Escape9002/ArcherTracking/3D-Boxen/README.md

This directory hold the cases in which the die is placed and attached to the body.
