Escape9002/ArcherTracking/Arduino_Code/README.md

Here is every firmware and a few tests for the BLE-Communication and the MPU9250.

## used:
- Arduino Nano 33 BLE
    - I²C
    - 3,3V
- MPU9250
    - I²C
    - 3,3V
    - DigitalMotionProcessor
    - Accleration, Gyroscope, Magnetometer (all in x,y,z)
