Escape9002/ArcherTracking/Documentation/2020/Hardware/Hardware.txt

- Arduino Nano 33 BLE
- MPU9250
- 9V-Battery
