Escape9002/ArcherTracking/Documentation/2021/Papers/sources.tex

\begin{itemize}
    \item Zuletzt besucht am 12.1.2022 | \textit{HowToMechatronics}\\
        \url{https://howtomechatronics.com/how-it-works/electrical-engineering/mems-accelerometer-gyrocope-magnetometer-arduino/}
    \item Zuletzt besucht am 12.1.2022 | \textit{NovelBits} \\
        \url{https://www.novelbits.io/bluetooth-5-speed-maximum-throughput/}
    \item Zuletzt besucht am 12.1.2022 | \textit{Journal of Mechanical Engineering and Sciences (JMES)} \\
        \url{http://jmes.ump.edu.my/images/Volume_6/4_Ahmad%20et%20al.pdf}
        %carefull this is an official PDF, cite it correctly
    \item Zuletzt besucht am 12.1.2022 | \textit{BatteryEquivalents}\\
        \url{https://www.batteryequivalents.com/lithium-cr2025-dl2025-e-cr2025-sb-t14-5003lc-br2025-lir2025-battery-equivalents.html}
    \item Zuletzt besucht am 12.1.2022 | \textit{akkuline.de}\\
        \url{https://www.akkuline.de/test/varta-high-energy-9v-batterie-test-messung}
    \item Zuletzt besucht am 12.1.2022 | \textit{Youtube | Google TechTalks} \\
        \url{https://www.youtube.com/watch?v=C7JQ7Rpwn2k}
    \item Zuletzt besucht am 2.3.2022 | \textit{Didaktik Mathematik HU Berlin | Quaternionen: von Hamilton, Basketbällen und anderen Katastrophen}
        \url{http://didaktik.mathematik.hu-berlin.de/files/2011_quaternionen.pdf}
\end{itemize}
