Escape9002/ArcherTracking/Documentation/2021/Papers/ArdFirmware.tex

Das selbst geschriebene Programm auf dem Arduino Nano 33 BLE stellt zu Beginn eine 
I$^2$C Verbindung mit dem MPU9250 her und startet das BLE-Modul.\\
Sobald ein Ger"at sich mit dem Arduino verbindet, beginnt dieser
mit der Datenübertragung.\\
Hierbei wurden die Filter vom Digital-Motion-Processor des MPU9250 
schon mit einem Low-Pass-Filter verarbeitet.
