Escape9002/ArcherTracking/Documentation/2021/Papers/Arduino.tex

Der Arduino Nano 33 BLE ist ein Prozessor aus dem Hause Arduino
der Nano Reihe. Was diesen von der normalen Nano-Reihe unterscheidet ist der BLE-Chip
NINA-b3(nRF52840) auf seinem Rücken. Dieser Chip ermöglicht es dem Arduino über 
Bluetooth 5.0, auch Bluetooth-Low-Energy genannt, mit allen anderen Bluetooth-Geräten ab 
der Bluetooth Version 4.0 kabellos zu kommunizieren.\\
\\
\begin{tabularx}{0.8\textwidth}{l|X}
Eigenschaft & Daten \\
\hline
Memory & 1MB Flash | 256 KB SRAM \\ 

Interfaces & $I^2C$, SPI, \dots \\

Volt & Input: 4,5 - 21 V | Output: 3,3 V\\
\end{tabularx}
\\
\\
Der Arduino ist aufgrund seines BLE-Chips, der I²C-Verbindungsmöglichkeit und der 
Output-Volt Zahl von 3,3 Volt der richtige Prozessor für dieses Projekt. Auch die 
kleinen Maße und das geringe Gewicht bringen ihm nur Pluspunkte ein.

% bringen statt spielen im letzen Satz? Sinnvoll ja/nein?
