Escape9002/ArcherTracking/Documentation/2021/Papers/winkMess.tex

Die Winkel Roll und Pitch können sehr genau bestimmt werden, hier die Tests:
