Escape9002/ArcherTracking/Documentation/2020/Papers/Plaktidee 1.pdf

Arduino Nano 33 BLE
- BLE-Chip
eingebaut
- klein + leicht

Bluetooth 4.0
Auch BLE genannt:
- geringer
Stromverbrauch
- Hohe Datenrate
- Starnetwork möglich

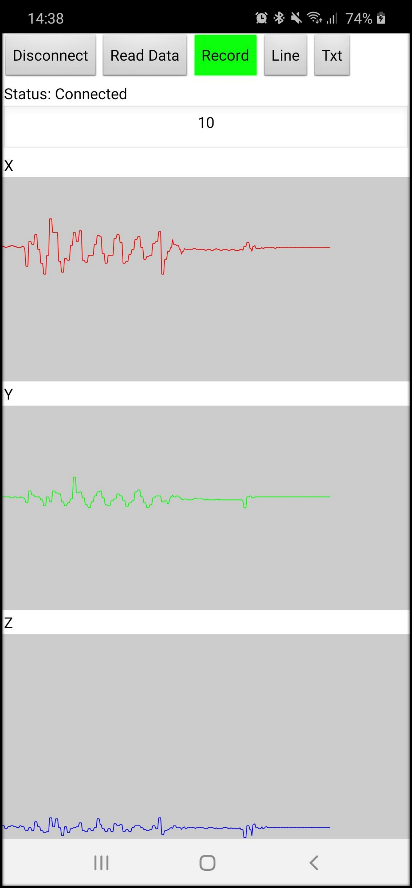
[picture p11: figure]

Bluetooth Low
Energy

MPU9250
→Multi-Chip (Achsen: 3)
- Beschleunigungssensor
- Gyroskop
- Magnetometer

I²C-BUS

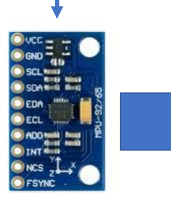
[picture p12: figure]

Mögliche 400kHz Senderate
(für alle Sensoren)

# Schützenvermessung als DIY-Version

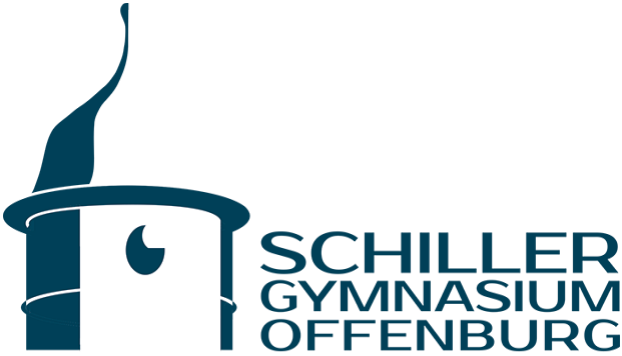
[picture p13: figure]

ein Projekt von Antonio Rehwinkel

Idee: Tracking eines Bogenschützen
→ altes System: teuer, kompliziert, platzintensiv →neues System: günstig, intuitiv, klein

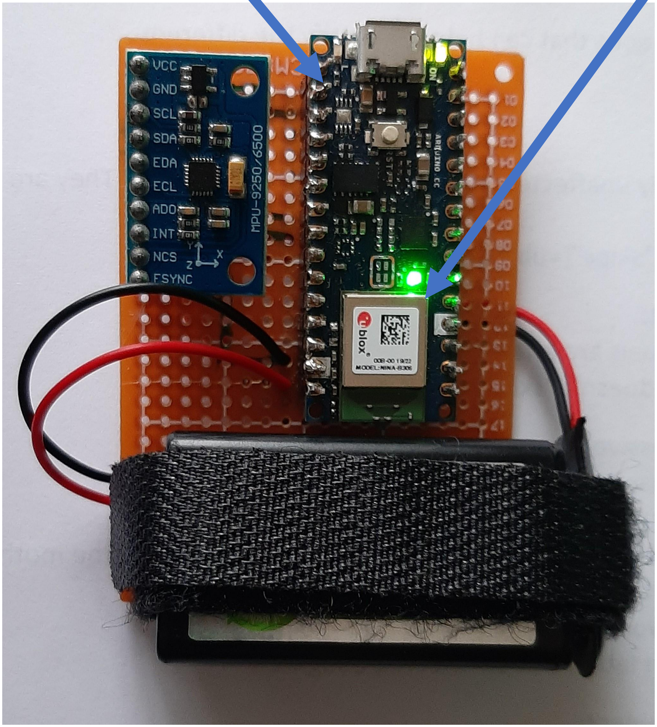
[picture p14: figure]

Getestete Senderate:
- Arduino: 22 Hz
- Smartphone: 52 Hz
