Escape9002/ArcherTracking/Documentation/2021/Papers/Danksagung.tex

Danke an \\
\begin{itemize}
    \item Herr Czernohous (Korrekturlesen der Arbeit und technische Hilfe, Kauf der Materialien) [Schiller Gymnasium Offenburg]
    \item Herr Dierle (Hilfe bei physikalischen Zusammenhängen und Formeln, Korrekturlesen der Arbeit) [Schiller Gymnasium Offenburg]
    \item R. Echle und R. Hilterhaus (f"ur Arbeitsideen und Hilfestellung) [Hochschule Offenburg]
\end{itemize}
