Escape9002/ArcherTracking/Documentation/2020/Hardware/dieBackside.jpg

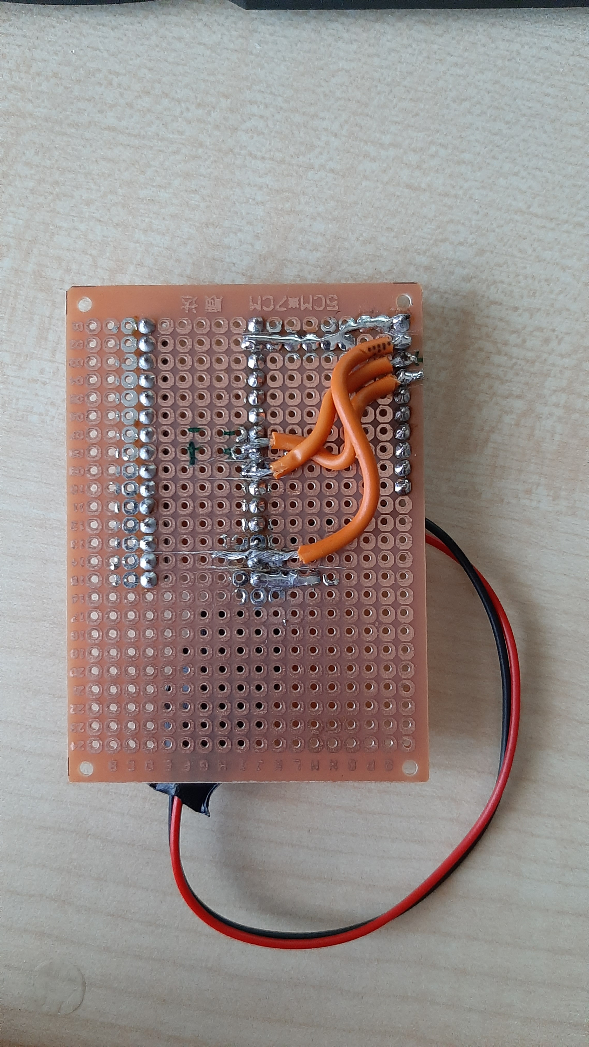
Documentation/2020/Hardware/dieBackside.jpg
