Escape9002/ArcherTracking/Documentation/2020/Hardware/dieFrontside.jpg

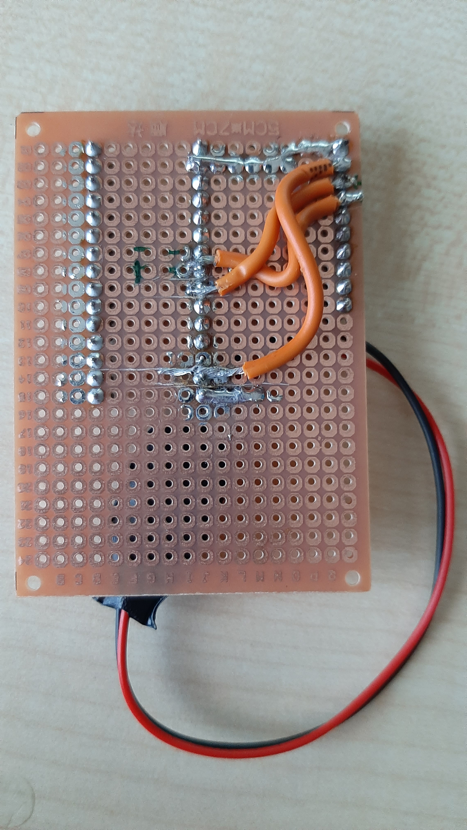
Documentation/2020/Hardware/dieFrontside.jpg
