Escape9002/ArcherTracking/Documentation/2020/Software/accelerationDetection.jpg

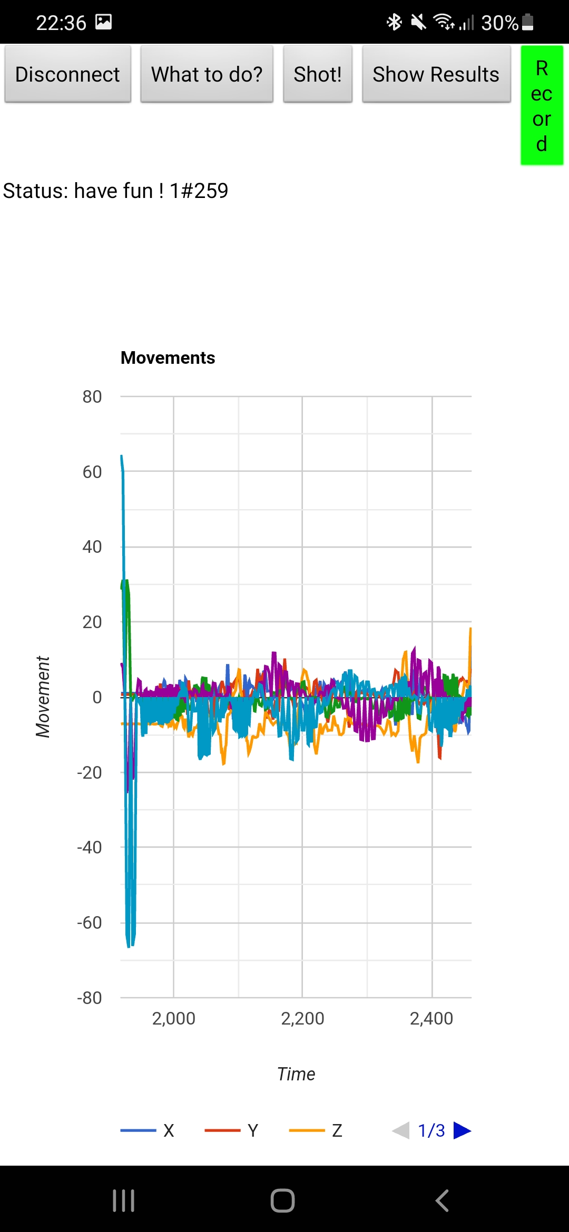
Documentation/2020/Software/accelerationDetection.jpg
