Escape9002/ArcherTracking/Documentation/2020/Software/textView.jpg

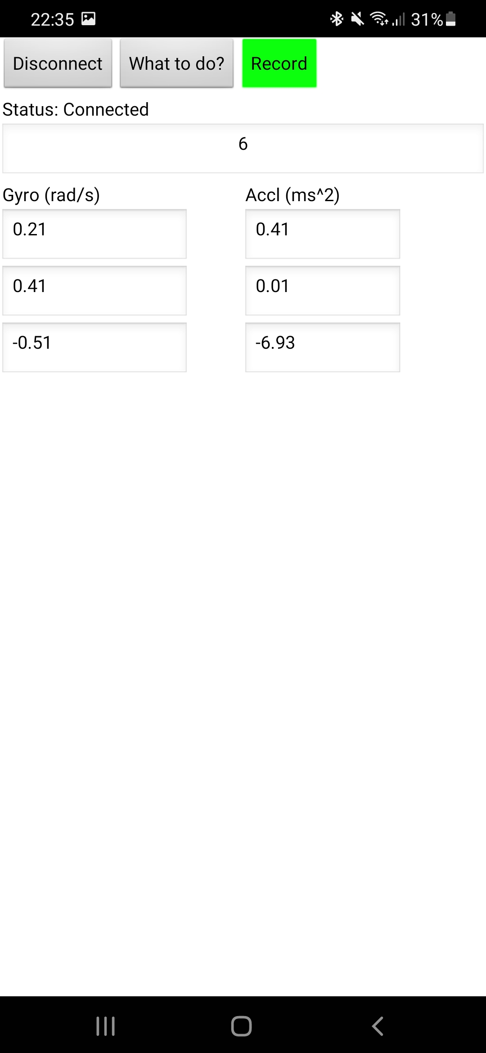
Documentation/2020/Software/textView.jpg
