Escape9002/ArcherTracking/Documentation/2021/Papers/Bilder/_integralDistance10.png

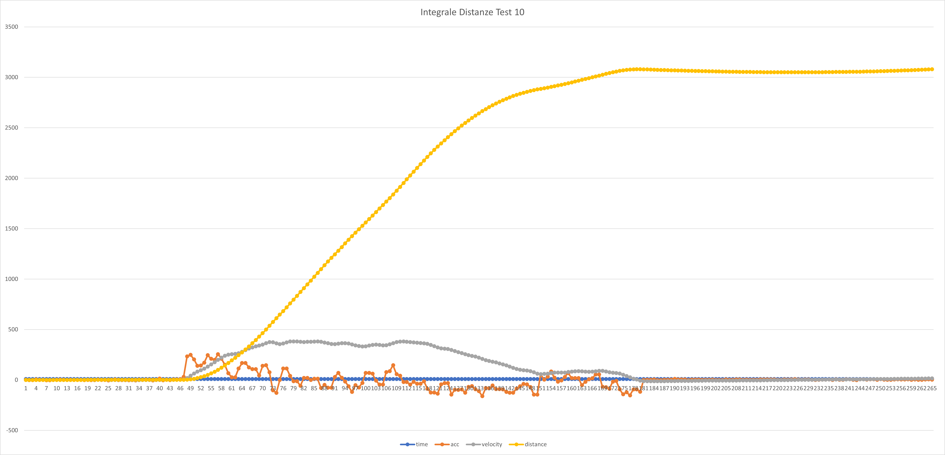
Documentation/2021/Papers/Bilder/_integralDistance10.png
