Escape9002/ArcherTracking/Documentation/2021/Papers/Bilder/constDistance1.png

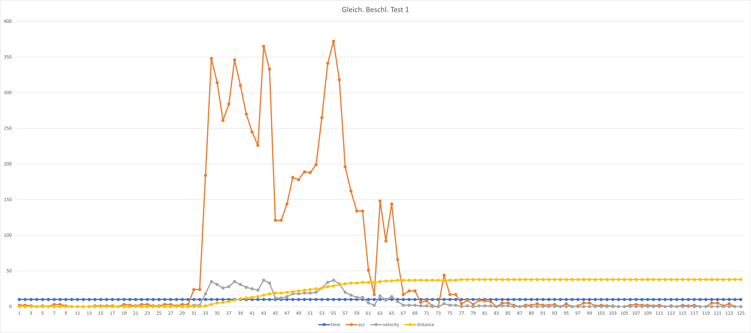
Documentation/2021/Papers/Bilder/constDistance1.png
