Escape9002/ArcherTracking/Documentation/2021/Papers/Bilder/constDistance2.png

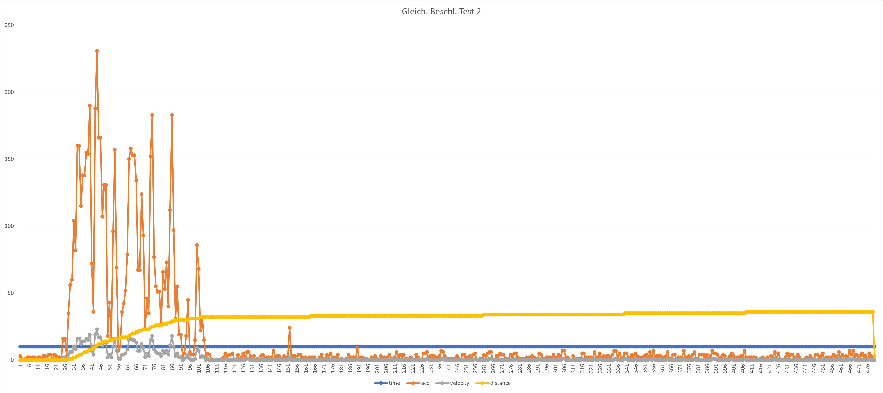
Documentation/2021/Papers/Bilder/constDistance2.png
