Escape9002/ArcherTracking/Documentation/2021/Papers/Bilder/graphAnimation.jpg

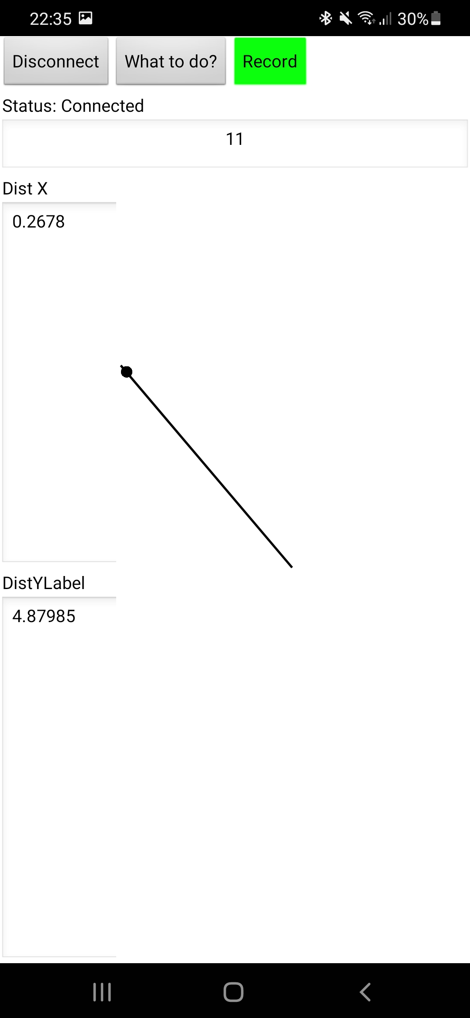
Documentation/2021/Papers/Bilder/graphAnimation.jpg
