Escape9002/ArcherTracking/Documentation/2021/Papers/Bilder/GraphAuswahl.jpg

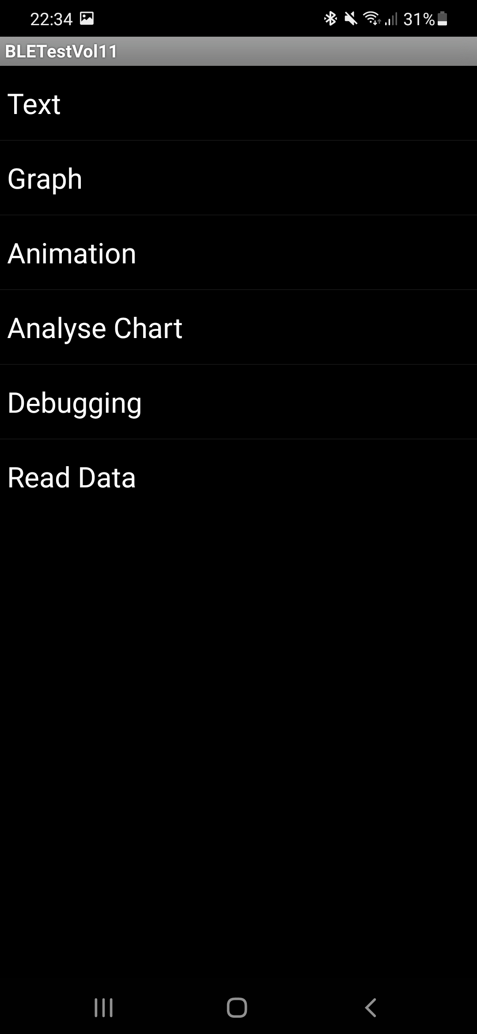
Documentation/2021/Papers/Bilder/GraphAuswahl.jpg
