Escape9002/ArcherTracking/Documentation/2021/Papers/Bilder/integralDistance3.png

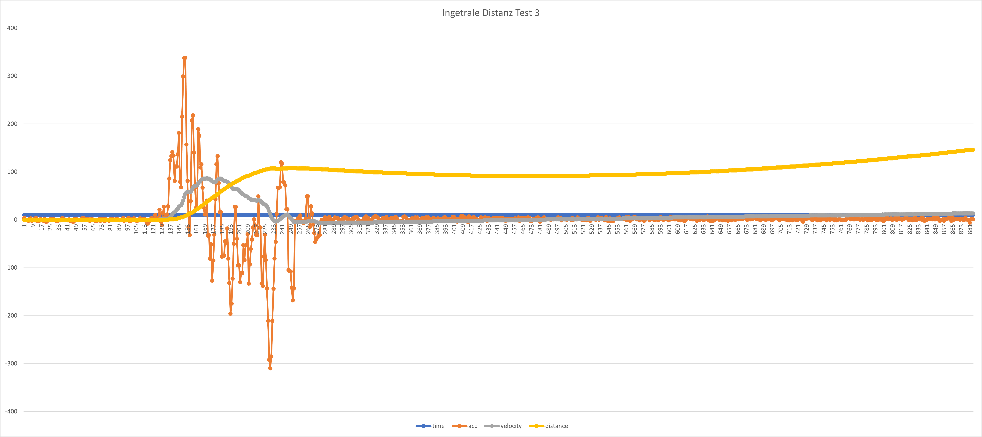
Documentation/2021/Papers/Bilder/integralDistance3.png
