Escape9002/ArcherTracking/Documentation/2021/Papers/Bilder/integralDistance4.png

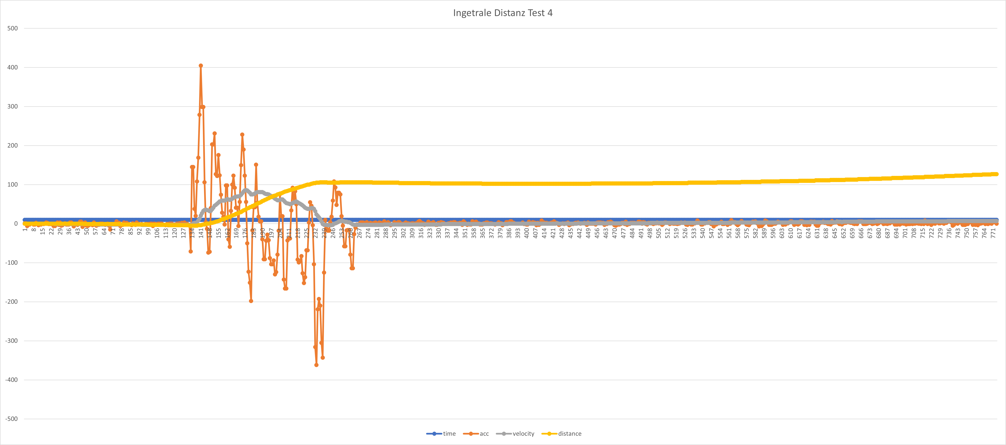
Documentation/2021/Papers/Bilder/integralDistance4.png
