Escape9002/ArcherTracking/MachineLearning/Data/2021/08102021/RAWData/SizeOfData3.png

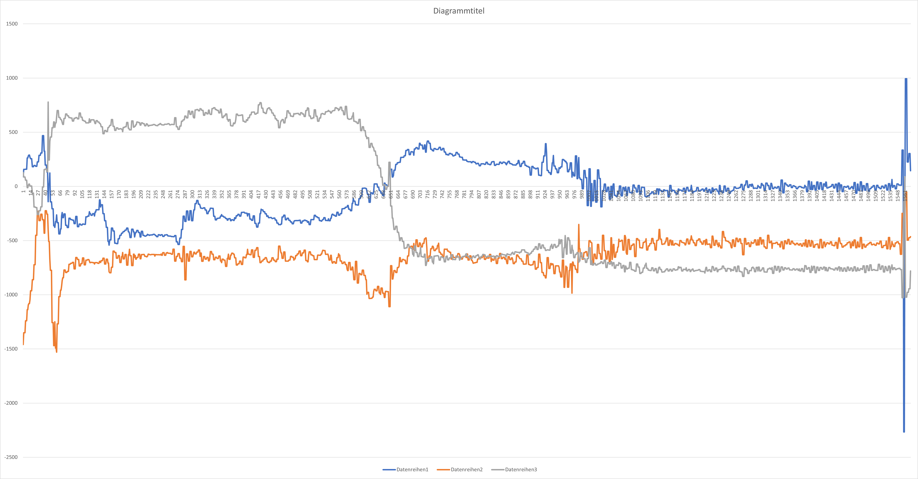
MachineLearning/Data/2021/08102021/RAWData/SizeOfData3.png
