Escape9002/ArcherTracking/MachineLearning/Data/2021/08102021/RAWData/SizeOfData.png

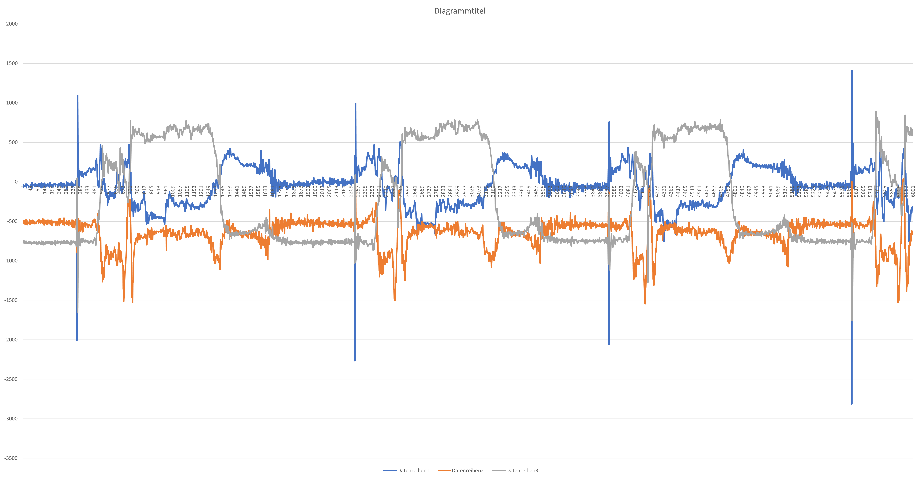
MachineLearning/Data/2021/08102021/RAWData/SizeOfData.png
