Escape9002/ArcherTracking/MATLAB/3D_Visual/OpenCV/ChessPatterns/chess7.jpg

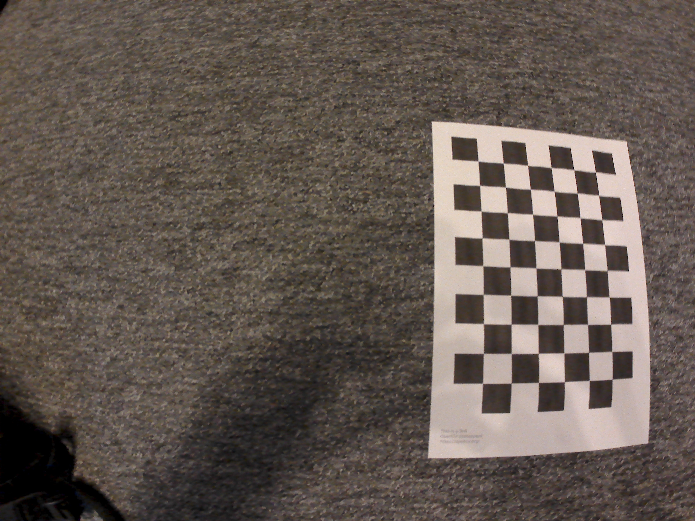
MATLAB/3D_Visual/OpenCV/ChessPatterns/chess7.jpg
