Escape9002/ArcherTracking/MATLAB/3D_Visual/OpenCV/ChessPatterns/chess8.jpg

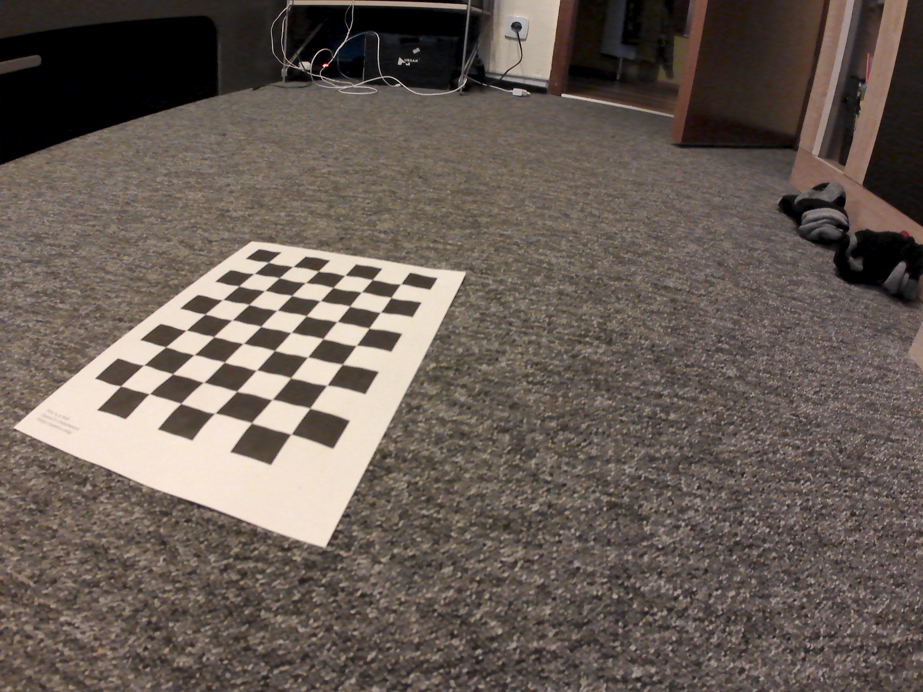
MATLAB/3D_Visual/OpenCV/ChessPatterns/chess8.jpg
