Escape9002/ArcherTracking/MATLAB/3D_Visual/OpenCV/ChessPatterns/chess9.jpg

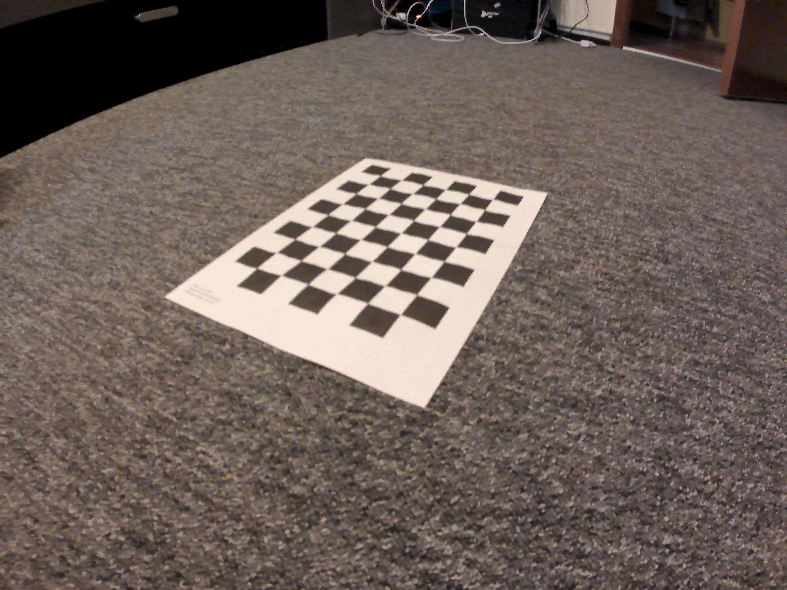
MATLAB/3D_Visual/OpenCV/ChessPatterns/chess9.jpg
