Escape9002/ArcherTracking/MATLAB/3D_Visual/OpenCV/ChessPatterns/chess12.jpg

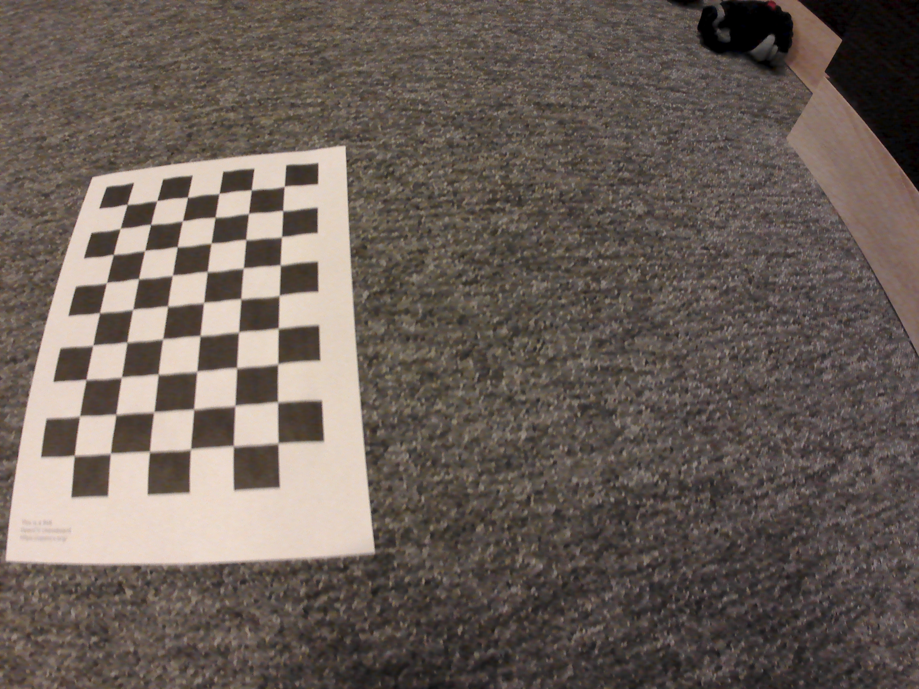
MATLAB/3D_Visual/OpenCV/ChessPatterns/chess12.jpg
