Escape9002/ArcherTracking/3D-Boxen/2020/DeckelFürSchachtelvol2.1.stl

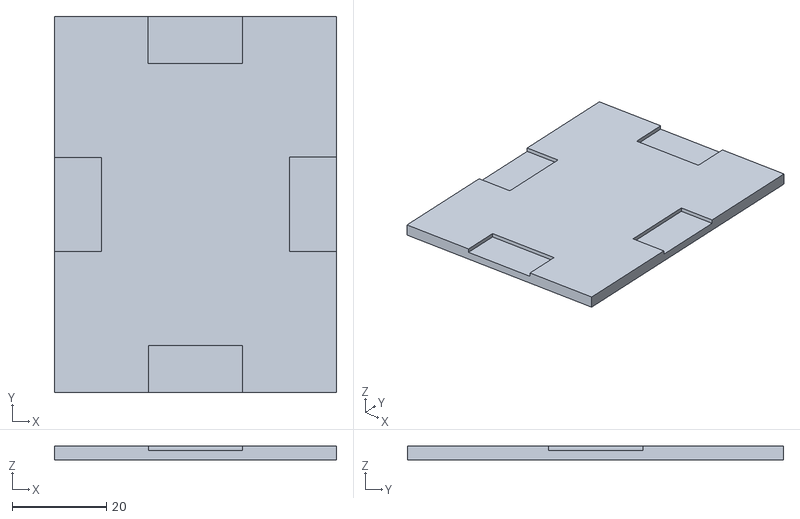
[picture p52: CAD file, 2021-06-13]
3D-Boxen/2020/DeckelFürSchachtelvol2.1.stl
60.0 x 80.0 x 3.00
