Escape9002/ArcherTracking/3D-Boxen/2021/ArcherDecker v5.stl

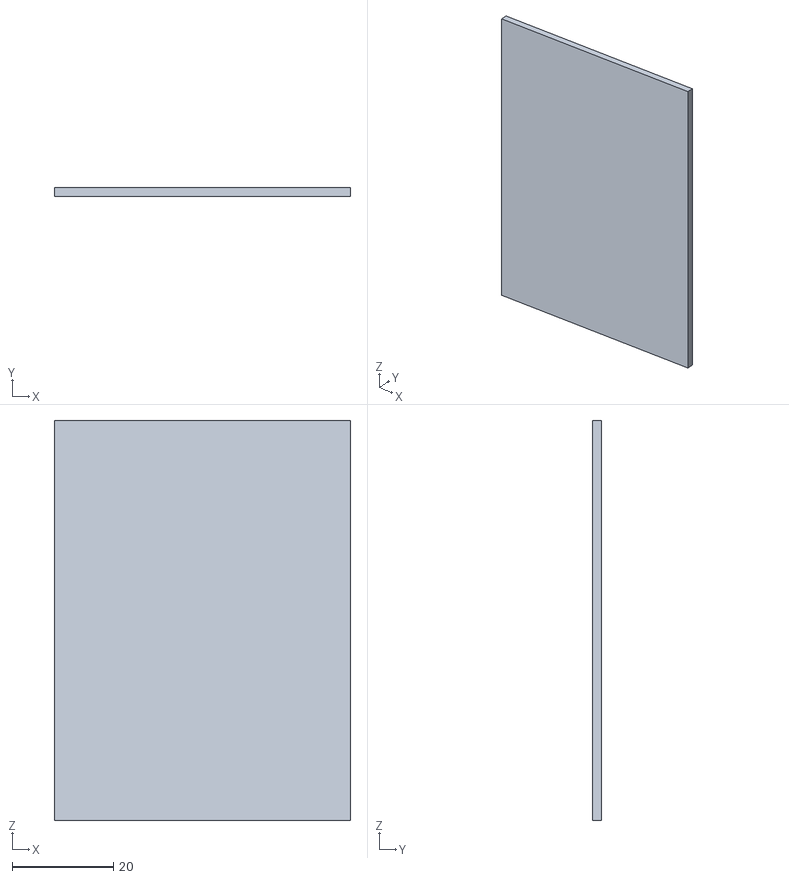
[picture p53: CAD file, 2022-01-31]
3D-Boxen/2021/ArcherDecker v5.stl
58.5 x 1.80 x 79.0
