Escape9002/ArcherTracking/3D-Boxen/2020/DeckelFürSchachtelVol2.stl

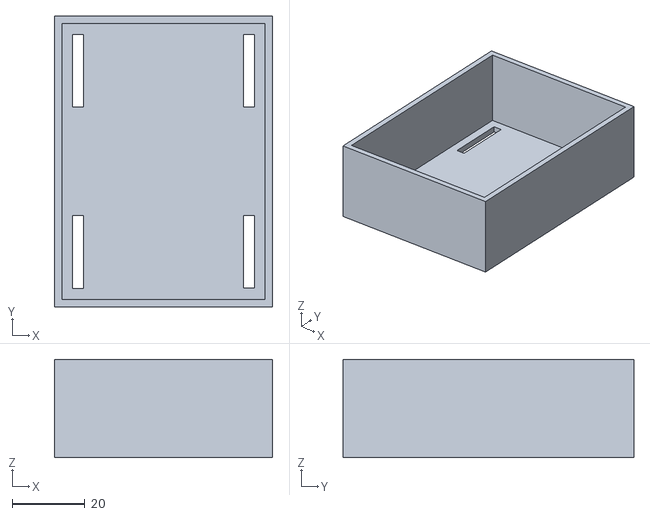
[picture p54: CAD file, 2021-06-13]
3D-Boxen/2020/DeckelFürSchachtelVol2.stl
60.0 x 80.0 x 27.0
