Escape9002/ArcherTracking/3D-Boxen/2021/ArcherBox v8.stl

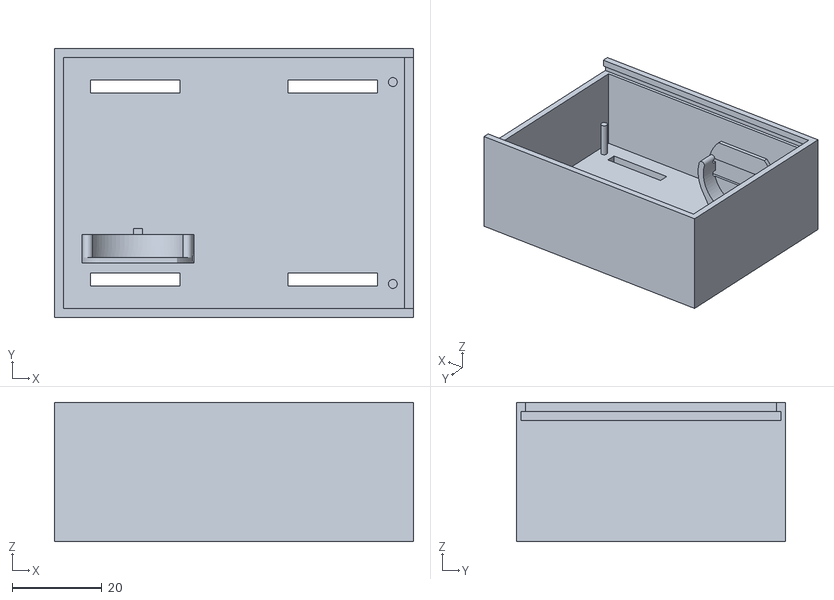
[picture p55: CAD file, 2022-01-31]
3D-Boxen/2021/ArcherBox v8.stl
80.0 x 60.0 x 31.0
