Escape9002/ArcherTracking/Documentation/2020/Hardware/installedModules.jpg

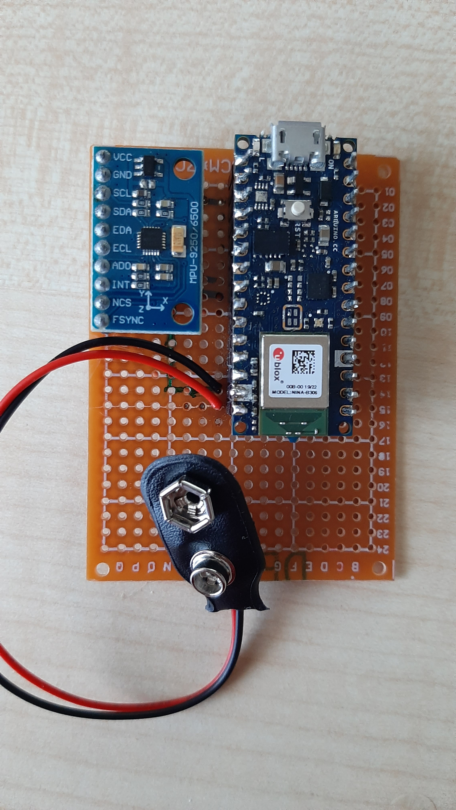
Documentation/2020/Hardware/installedModules.jpg
