Escape9002/ArcherTracking/MachineLearning/DataTest/left.csv

aX | aY | aZ | gX | gY | gZ
-0.565 | -1.617 | 1.039 | -116.272 | -39.612 | -60.364
-0.548 | -1.497 | 0.921 | -110.046 | -34.058 | -23.071
-0.603 | -1.430 | 0.745 | -99.548 | -27.588 | 9.583
-0.662 | -1.315 | 0.698 | -90.149 | -31.860 | 37.903
-0.738 | -1.178 | 0.627 | -82.520 | -37.415 | 66.040
-0.750 | -1.041 | 0.733 | -75.867 | -45.227 | 89.478
-0.780 | -1.021 | 0.866 | -73.608 | -46.814 | 106.750
-0.819 | -0.927 | 0.939 | -77.454 | -41.382 | 124.023
-0.873 | -0.885 | 0.960 | -84.717 | -31.616 | 139.526
-0.944 | -0.917 | 0.887 | -94.604 | -21.484 | 153.259
-0.945 | -1.046 | 0.827 | -108.459 | -15.198 | 168.213
-0.904 | -1.263 | 1.039 | -117.004 | -17.517 | 186.157
-0.905 | -1.395 | 1.094 | -116.882 | -10.986 | 210.876
-0.927 | -1.456 | 1.169 | -107.788 | -0.244 | 241.272
-1.013 | -1.463 | 1.153 | -94.910 | 12.817 | 274.048
-1.166 | -1.275 | 1.002 | -86.304 | 29.358 | 311.890
-1.310 | -1.052 | 0.904 | -79.102 | 38.574 | 346.191
-1.409 | -0.828 | 0.833 | -70.251 | 40.100 | 372.009
-1.477 | -0.600 | 0.791 | -59.692 | 38.574 | 392.517
-1.545 | -0.357 | 0.811 | -47.302 | 34.912 | 406.067
-1.547 | -0.087 | 0.821 | -34.424 | 33.447 | 413.025
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
