Escape9002/ArcherTracking/MachineLearning/DataTest/right.csv

aX | aY | aZ | gX | gY | gZ
-0.099 | 1.443 | 1.957 | -5.188 | 43.701 | -41.077
-0.279 | 1.458 | 1.604 | -15.381 | 74.158 | -85.083
-0.463 | 1.192 | 0.993 | -21.973 | 102.478 | -134.155
-0.646 | 0.787 | 0.874 | -31.799 | 90.881 | -175.293
-0.772 | 0.286 | 1.086 | -42.603 | 65.491 | -201.904
-0.799 | -0.032 | 1.397 | -55.725 | 54.016 | -211.670
-0.778 | 0.047 | 1.547 | -59.692 | 62.927 | -208.618
-0.810 | 0.101 | 1.499 | -52.673 | 83.679 | -214.294
-0.879 | -0.058 | 1.378 | -41.565 | 102.783 | -233.887
-0.863 | -0.178 | 1.313 | -26.855 | 114.014 | -250.305
-0.825 | -0.147 | 1.367 | -11.475 | 120.789 | -260.132
-0.827 | -0.048 | 1.394 | 1.038 | 134.583 | -271.301
-0.818 | 0.125 | 1.397 | 5.615 | 157.410 | -286.743
-0.835 | 0.441 | 1.387 | 1.770 | 183.167 | -306.335
-0.915 | 0.741 | 1.514 | -5.432 | 203.491 | -337.952
-1.227 | 0.772 | 1.380 | -3.662 | 224.792 | -384.521
-1.673 | 0.337 | 1.144 | 6.592 | 242.981 | -440.491
-2.154 | -0.323 | 0.738 | 30.457 | 253.418 | -486.145
-2.463 | -1.134 | 0.028 | 64.819 | 256.226 | -504.211
-2.490 | -1.868 | -0.281 | 78.491 | 231.812 | -494.995
-2.325 | -2.016 | -0.019 | 63.843 | 195.068 | -454.956
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
