Escape9002/ArcherTracking/MachineLearning/DataTest/22032022/flex.csv

aX | aY | aZ | gX | gY | gZ
-5.689 | -4.195 | -40.764 | 10.686 | 10.686 | 10.686
-9.706 | -3.984 | -41.444 | -2.390 | -2.390 | -2.390
-12.651 | -2.796 | -35.167 | -5.323 | -5.323 | -5.323
-13.082 | -1.116 | -25.355 | -2.157 | -2.157 | -2.157
-13.082 | -1.116 | -25.355 | -2.157 | -2.157 | -2.157
-10.334 | 0.441 | -5.636 | -16.106 | -16.106 | -16.106
-8.629 | 0.153 | -1.034 | -13.872 | -13.872 | -13.872
-7.288 | -0.426 | 0.718 | -2.837 | -2.837 | -2.837
-6.244 | -0.383 | 1.082 | 2.254 | 2.254 | 2.254
-4.894 | 0.254 | 1.432 | 3.750 | 3.750 | 3.750
-4.894 | 0.254 | 1.432 | 3.750 | 3.750 | 3.750
-2.164 | 1.183 | 3.414 | 1.768 | 1.768 | 1.768
-0.484 | 0.718 | 4.252 | 3.769 | 3.769 | 3.769
1.197 | 1.288 | 4.367 | 6.994 | 6.994 | 6.994
1.197 | 1.288 | 4.367 | 6.994 | 6.994 | 6.994
2.600 | 1.542 | 4.745 | -0.233 | -0.233 | -0.233
3.041 | 1.695 | 6.340 | -6.450 | -6.450 | -6.450
5.004 | 3.050 | 7.647 | -9.345 | -9.345 | -9.345
5.004 | 3.050 | 7.647 | -9.345 | -9.345 | -9.345
8.547 | 3.711 | 5.909 | -0.389 | -0.389 | -0.389
9.405 | 3.117 | 4.597 | 1.457 | 1.457 | 1.457
10.310 | 2.897 | 4.468 | -4.138 | -4.138 | -4.138
10.458 | 2.318 | 3.678 | -7.227 | -7.227 | -7.227
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
