Escape9002/ArcherTracking/MachineLearning/DataTest/22032022/punch.csv

aX | aY | aZ | gX | gY | gZ
24.158 | -3.271 | -8.456 | 20.555 | 20.555 | 20.555
24.158 | -3.271 | -8.456 | 20.555 | 20.555 | 20.555
22.266 | -9.065 | -9.232 | -7.227 | -7.227 | -7.227
17.847 | -11.483 | -8.768 | -26.092 | -26.092 | -26.092
16.520 | -10.080 | -14.495 | -34.660 | -34.660 | -34.660
14.739 | -7.087 | -7.183 | -23.800 | -23.800 | -23.800
12.053 | -0.685 | 2.954 | -14.804 | -14.804 | -14.804
5.837 | 4.765 | 10.286 | -17.991 | -17.991 | -17.991
-9.601 | 2.308 | 6.110 | -33.475 | -33.475 | -33.475
-20.442 | -1.255 | -10.635 | -38.332 | -38.332 | -38.332
-20.442 | -1.255 | -10.635 | -38.332 | -38.332 | -38.332
-27.701 | 3.390 | -4.132 | 28.093 | 28.093 | 28.093
-30.263 | 0.211 | 1.211 | 9.831 | 9.831 | 9.831
-30.263 | 0.211 | 1.211 | 9.831 | 9.831 | 9.831
-26.566 | -2.303 | -3.807 | -55.410 | -55.410 | -55.410
-16.515 | -4.496 | -28.563 | -38.896 | -38.896 | -38.896
-8.926 | -6.292 | -26.691 | 11.560 | 11.560 | 11.560
-8.926 | -6.292 | -26.691 | 11.560 | 11.560 | 11.560
-4.367 | 3.108 | 0.723 | 60.850 | 60.850 | 60.850
-4.367 | 3.108 | 0.723 | 60.850 | 60.850 | 60.850
-2.140 | 4.046 | 5.143 | 24.460 | 24.460 | 24.460
-3.898 | 1.528 | -5.646 | -26.792 | -26.792 | -26.792
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
