Escape9002/ArcherTracking/MachineLearning/DataTest/20022022/draw.csv

aX | aY | aZ | gX | gY | gZ
-17.459 | -12.780 | -1.882 | -17.097 | -17.097 | -17.097
-20.466 | -15.098 | -1.216 | -14.707 | -14.707 | -14.707
-21.285 | -17.808 | -1.508 | -9.714 | -9.714 | -9.714
-17.641 | -19.484 | -2.265 | -8.199 | -8.199 | -8.199
-14.188 | -20.227 | -3.424 | -3.925 | -3.925 | -3.925
-10.975 | -21.673 | -5.818 | 1.632 | 1.632 | 1.632
-10.975 | -21.673 | -5.818 | 1.632 | 1.632 | 1.632
-4.199 | -18.733 | -4.616 | 2.429 | 2.429 | 2.429
-2.207 | -16.243 | -3.845 | 1.496 | 1.496 | 1.496
-0.464 | -13.776 | -3.098 | 2.390 | 2.390 | 2.390
-0.464 | -13.776 | -3.098 | 2.390 | 2.390 | 2.390
-0.484 | -9.730 | -1.489 | 14.260 | 14.260 | 14.260
-0.867 | -8.251 | -1.690 | 16.359 | 16.359 | 16.359
-0.867 | -8.251 | -1.690 | 16.359 | 16.359 | 16.359
0.029 | -2.978 | -0.010 | 2.293 | 2.293 | 2.293
0.618 | -0.991 | 1.183 | 2.662 | 2.662 | 2.662
-0.536 | 0.350 | 1.647 | 3.925 | 3.925 | 3.925
-0.948 | 0.814 | 2.016 | 6.042 | 6.042 | 6.042
-1.949 | 1.537 | 1.911 | 6.567 | 6.567 | 6.567
-2.528 | 1.982 | 2.313 | 6.081 | 6.081 | 6.081
-3.381 | 2.117 | 2.466 | 9.559 | 9.559 | 9.559
-4.204 | 1.705 | 1.671 | 15.815 | 15.815 | 15.815
-5.205 | 1.221 | 0.785 | 17.447 | 17.447 | 17.447
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
