Escape9002/ArcherTracking/MachineLearning/DataTest/20022022/pull.csv

aX | aY | aZ | gX | gY | gZ
-14.801 | -18.249 | 0.340 | -11.560 | -11.560 | -11.560
-14.801 | -18.249 | 0.340 | -11.560 | -11.560 | -11.560
-7.278 | -16.123 | -0.115 | -27.938 | -27.938 | -27.938
-3.941 | -10.334 | 1.714 | -35.845 | -35.845 | -35.845
-4.664 | -5.622 | 3.764 | -34.932 | -34.932 | -34.932
-5.248 | -1.082 | 5.114 | -30.211 | -30.211 | -30.211
-5.291 | 1.470 | 5.990 | -24.732 | -24.732 | -24.732
-5.823 | 3.203 | 5.219 | -12.881 | -12.881 | -12.881
-6.761 | 4.779 | 5.071 | -3.672 | -3.672 | -3.672
-8.892 | 4.760 | 5.373 | 1.282 | 1.282 | 1.282
-10.295 | 4.736 | 5.387 | 4.061 | 4.061 | 4.061
-11.013 | 3.266 | 4.975 | 3.886 | 3.886 | 3.886
-11.617 | 2.389 | 5.526 | 4.099 | 4.099 | 4.099
-11.617 | 2.389 | 5.526 | 4.099 | 4.099 | 4.099
-11.104 | 2.059 | 5.895 | 9.131 | 9.131 | 9.131
-10.961 | 1.829 | 5.339 | 24.208 | 24.208 | 24.208
-11.545 | 1.599 | 4.247 | 27.763 | 27.763 | 27.763
-11.373 | 1.240 | 4.324 | 28.715 | 28.715 | 28.715
-10.851 | 1.417 | 4.199 | 29.570 | 29.570 | 29.570
-10.851 | 1.417 | 4.199 | 29.570 | 29.570 | 29.570
-9.740 | 1.216 | 2.773 | 35.088 | 35.088 | 35.088
-10.448 | 1.125 | 2.112 | 32.037 | 32.037 | 32.037
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
