Escape9002/ArcherTracking/MachineLearning/DataTest/11122021/punch.csv

aX | aY | aZ | gX | gY | gZ
1.305 | 0.267 | 1.485 | 33.997 | -19.836 | 4.578
1.399 | 0.320 | 1.609 | 35.950 | -12.085 | 2.869
1.791 | 0.395 | 1.642 | 44.067 | -3.723 | 0.366
1.927 | 0.474 | 1.795 | 37.964 | -7.568 | 1.038
1.955 | 0.542 | 1.947 | 30.762 | -7.080 | -0.549
1.817 | 0.605 | 2.063 | 22.034 | 3.235 | -0.183
1.678 | 0.686 | 2.110 | 9.155 | 23.560 | 1.709
1.488 | 0.835 | 2.118 | 0.000 | 51.147 | 10.620
1.350 | 1.009 | 2.006 | -14.832 | 81.299 | 17.761
1.232 | 1.175 | 1.808 | -19.592 | 116.089 | 16.968
1.042 | 1.285 | 1.596 | -16.418 | 151.917 | 4.822
1.142 | 1.301 | 1.273 | 5.981 | 190.918 | -23.315
1.071 | 1.149 | 1.019 | 31.250 | 220.947 | -65.063
0.908 | 0.809 | 0.767 | 63.843 | 250.183 | -116.821
0.668 | 0.382 | 0.505 | 96.008 | 278.381 | -157.715
0.371 | -0.039 | 0.221 | 115.356 | 298.584 | -177.185
0.182 | -0.393 | -0.102 | 122.803 | 304.687 | -169.006
-0.005 | -0.637 | -0.416 | 117.310 | 288.330 | -136.292
-0.288 | -0.773 | -0.682 | 102.051 | 248.230 | -88.745
-0.369 | -0.745 | -0.873 | 79.651 | 181.396 | -27.771
-0.490 | -0.518 | -0.884 | 53.040 | 89.294 | 41.382
-0.437 | -0.170 | -0.676 | 34.363 | -5.493 | 92.468
-0.251 | 0.040 | -0.286 | 35.522 | -91.553 | 98.083
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
