Escape9002/ArcherTracking/MATLAB/TestsNTutorials/Orientierung/AusgabeTests/pitch.csv

Roll | Pitch | Yaw | RollF | PitchF | YawF
0.137618 | 3.13147 | -64.2132 | 0 | 0 | -64.2132
0.197233 | 3.16438 | -64.2755 | 0 | 0 | -64.2755
0.294175 | 3.25166 | -64.3416 | 0 | 0 | -64.3416
0.140738 | 3.31976 | -64.4039 | 0 | 0 | -64.4039
0.239658 | 3.29358 | -64.4678 | 0 | 0 | -64.4678
0.258138 | 3.21095 | -64.5377 | 0 | 0 | -64.5377
0.196412 | 3.46386 | -64.5962 | 0 | 0 | -64.5962
-0.0246533 | 3.00909 | -64.6502 | 0 | 0 | -64.6502
0.151079 | 3.13909 | -64.7277 | 0 | 0 | -64.7277
0.203894 | 3.07042 | -64.7892 | 0 | 0 | -64.7892
0.176469 | 3.24392 | -64.8554 | 0 | 0 | -64.8554
0.254971 | 0.206072 | -64.9215 | 0 | 0 | -64.9215
0.213678 | -0.813379 | -64.9283 | 0 | 0 | -64.9283
0.253488 | -6.48126 | -65.0378 | 0 | 0 | -65.0378
0.57248 | -15.1184 | -65.1654 | 0 | 0 | -65.1654
0.527566 | -28.5737 | -64.8911 | 0 | 0 | -64.8911
0.504991 | -38.1669 | -64.7056 | 0 | 0 | -64.7056
0.176384 | -42.9089 | -64.5316 | 0 | 0 | -64.5316
0.551378 | -48.3466 | -64.6213 | 0 | 0 | -64.6213
0.557308 | -56.1503 | -64.8037 | 0 | 0 | -64.8037
0.667944 | -60.5827 | -64.9215 | 0 | 0 | -64.9215
0.851022 | -72.2023 | -65.0636 | 0 | 0 | -65.0636
0.687336 | -74.2039 | -65.2027 | 0 | 0 | -65.2027
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
