Escape9002/ArcherTracking/MATLAB/TestsNTutorials/Orientierung/AusgabeTests/roll.csv

Roll | Pitch | Yaw | RollF | PitchF | YawF
0.0914095 | 3.22917 | -49.7496 | 0 | 0 | -49.7496
0.12334 | 3.15558 | -49.8142 | 0 | 0 | -49.8142
0.140829 | 3.16674 | -49.8704 | 0 | 0 | -49.8704
0.224516 | 3.14128 | -49.932 | 0 | 0 | -49.932
0.0634199 | 3.10204 | -49.9913 | 0 | 0 | -49.9913
0.207771 | 3.17805 | -50.049 | 0 | 0 | -50.049
0.10548 | 3.21883 | -50.1106 | 0 | 0 | -50.1106
0.442371 | 1.76975 | -50.1684 | 0 | 0 | -50.1684
0.119763 | 3.17533 | -50.2322 | 0 | 0 | -50.2322
0.0527679 | 3.11836 | -50.2938 | 0 | 0 | -50.2938
0.161532 | 3.12333 | -50.3599 | 0 | 0 | -50.3599
0.179161 | 3.09641 | -50.4252 | 0 | 0 | -50.4252
0.218063 | 3.37842 | -50.6874 | 0 | 0 | -50.6874
0.241206 | 2.89214 | -50.7513 | 0 | 0 | -50.7513
0.55902 | 0.394805 | -51.2286 | 0 | 0 | -51.2286
0.0523386 | 2.87634 | -51.1328 | 0 | 0 | -51.1328
1.01331 | 2.58841 | -51.0173 | 0 | 0 | -51.0173
6.27751 | 3.13928 | -50.2816 | 0 | 0 | -50.2816
12.6311 | 2.85076 | -49.9221 | 0 | 0 | -49.9221
19.7286 | 2.29436 | -49.7618 | 0 | 0 | -49.7618
29.3511 | 1.89888 | -49.8894 | 0 | 0 | -49.8894
38.3178 | 1.20873 | -50.2596 | 0 | 0 | -50.2596
44.3117 | 1.84319 | -50.2178 | 0 | 0 | -50.2178
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
