Escape9002/ArcherTracking/MATLAB/TestsNTutorials/Orientierung/AusgabeTests/yaw.csv

Roll | Pitch | Yaw | RollF | PitchF | YawF
0.196865 | 3.18664 | -75.7386 | 0 | 0 | -75.7386
0.0035231 | 3.16889 | -75.8009 | 0 | 0 | -75.8009
0.116068 | 3.24109 | -75.8662 | 0 | 0 | -75.8662
0.130138 | 3.17416 | -75.9324 | 0 | 0 | -75.9324
0.179702 | 3.15871 | -75.9924 | 0 | 0 | -75.9924
0.18236 | 3.16133 | -76.0524 | 0 | 0 | -76.0524
0.204077 | 3.16127 | -76.1132 | 0 | 0 | -76.1132
0.199887 | 3.32278 | -76.171 | 0 | 0 | -76.171
0.130334 | 3.27068 | -76.231 | 0 | 0 | -76.231
0.105859 | 3.32584 | -76.2964 | 0 | 0 | -76.2964
0.168931 | 3.35942 | -76.3435 | 0 | 0 | -76.3435
0.147947 | 3.4436 | -76.418 | 0 | 0 | -76.418
0.322843 | 3.06143 | -77.4448 | 0 | 0 | -77.4448
0.549814 | 1.73668 | -79.303 | 0 | 0 | -79.303
-0.216912 | 3.86467 | -83.3492 | 0 | 0 | -83.3492
0.606452 | 3.5487 | -90.0091 | 0 | 0 | -90.0091
-0.281211 | 3.98285 | -97.5483 | 0 | 0 | -97.5483
-0.2061073 | 4.104326 | -105.4857 | 0 | 0 | -105.4857
-0.1815683 | 4.929776 | -112.6586 | 0 | 0 | -112.6586
-1.108162 | 4.021893 | -120.2822 | 0 | 0 | -120.2822
0.09515673 | 4.130558 | -128.1558 | 0 | 0 | -128.1558
0.3809382 | 2.46111 | -135.9686 | 0 | 0 | -135.9686
-1.086423 | 5.314742 | -144.0899 | 0 | 0 | -144.0899
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
