Escape9002/ArcherTracking/Arduino_Code/Tests/MPU_9250/Distance2/measuredDistances/constDistance.csv

time | acc | velocity | distance
0.10 | 0.02 | 0.00 | 0.00
0.10 | 0.02 | 0.00 | 0.00
0.10 | 0.01 | 0.00 | 0.00
0.10 | 0.00 | 0.00 | 0.00
0.10 | 0.01 | 0.00 | 0.00
0.10 | 0.00 | 0.00 | 0.00
0.10 | 0.03 | 0.00 | 0.00
0.10 | 0.03 | 0.00 | 0.00
0.10 | 0.01 | 0.00 | 0.00
0.10 | 0.00 | 0.00 | 0.00
0.10 | 0.00 | 0.00 | 0.00
0.10 | 0.00 | 0.00 | 0.00
0.10 | 0.00 | 0.00 | 0.00
0.10 | 0.01 | 0.00 | 0.00
0.10 | 0.01 | 0.00 | 0.00
0.10 | 0.01 | 0.00 | 0.00
0.10 | 0.01 | 0.00 | 0.00
0.10 | 0.00 | 0.00 | 0.00
0.10 | 0.03 | 0.00 | 0.00
0.10 | 0.02 | 0.00 | 0.00
0.10 | 0.01 | 0.00 | 0.00
0.10 | 0.03 | 0.00 | 0.00
0.10 | 0.03 | 0.00 | 0.00
0.10 | 0.01 | 0.00 | 0.00
0.10 | 0.01 | 0.00 | 0.00
0.10 | 0.03 | 0.00 | 0.00
0.10 | 0.03 | 0.00 | 0.00
0.10 | 0.01 | 0.00 | 0.00
0.10 | 0.03 | 0.00 | 0.00
0.10 | 0.03 | 0.00 | 0.00
0.10 | 0.24 | 0.02 | 0.00
0.10 | 0.24 | 0.02 | 0.00
0.10 | 1.84 | 0.18 | 0.01
0.10 | 3.48 | 0.35 | 0.03
0.10 | 3.14 | 0.31 | 0.05
0.10 | 2.61 | 0.26 | 0.06
0.10 | 2.84 | 0.28 | 0.07
0.10 | 3.46 | 0.35 | 0.09
0.10 | 3.10 | 0.31 | 0.11
0.10 | 2.70 | 0.27 | 0.12
0.10 | 2.45 | 0.25 | 0.13
0.10 | 2.26 | 0.23 | 0.14
0.10 | 3.65 | 0.37 | 0.16
0.10 | 3.33 | 0.33 | 0.18
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
