Escape9002/ArcherTracking/Arduino_Code/Tests/MPU_9250/Distance2/measuredDistances/constDistance001.csv

time | acc | velocity | distance
0.10 | 0.04 | 0.00 | 0.00
0.10 | 0.01 | 0.00 | 0.00
0.10 | 0.01 | 0.00 | 0.00
0.10 | 0.02 | 0.00 | 0.00
0.10 | 0.02 | 0.00 | 0.00
0.10 | 0.04 | 0.00 | 0.00
0.10 | 0.04 | 0.00 | 0.00
0.10 | 0.02 | 0.00 | 0.00
0.10 | 0.03 | 0.00 | 0.00
0.10 | 0.03 | 0.00 | 0.00
0.10 | 0.05 | 0.00 | 0.00
0.10 | 0.01 | 0.00 | 0.00
0.10 | 0.02 | 0.00 | 0.00
0.10 | 0.02 | 0.00 | 0.00
0.10 | 0.03 | 0.00 | 0.00
0.10 | 0.05 | 0.01 | 0.00
0.10 | 0.03 | 0.00 | 0.00
0.10 | 0.04 | 0.00 | 0.00
0.10 | 0.03 | 0.00 | 0.00
0.10 | 0.03 | 0.00 | 0.00
0.10 | 0.03 | 0.00 | 0.00
0.10 | 0.03 | 0.00 | 0.00
0.10 | 0.03 | 0.00 | 0.00
0.10 | 0.01 | 0.00 | 0.00
0.10 | 0.01 | 0.00 | 0.00
0.10 | 0.06 | 0.01 | 0.00
0.10 | 0.02 | 0.00 | 0.00
0.10 | 0.02 | 0.00 | 0.00
0.10 | 0.01 | 0.00 | 0.00
0.10 | 0.01 | 0.00 | 0.00
0.10 | 0.04 | 0.00 | 0.00
0.10 | 0.02 | 0.00 | 0.00
0.10 | 0.02 | 0.00 | 0.00
0.10 | 0.03 | 0.00 | 0.00
0.10 | 0.03 | 0.00 | 0.00
0.10 | 0.00 | 0.00 | 0.00
0.10 | 0.01 | 0.00 | 0.00
0.10 | 0.04 | 0.00 | 0.00
0.10 | 0.04 | 0.00 | 0.00
0.10 | 0.03 | 0.00 | 0.01
0.10 | 0.07 | 0.01 | 0.01
0.10 | 0.03 | 0.00 | 0.01
0.10 | 0.03 | 0.00 | 0.01
0.10 | 0.00 | 0.00 | 0.01
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
