Escape9002/ArcherTracking/Arduino_Code/Tests/MPU_9250/Distance2/measuredDistances/constDistance2.csv

time | acc | velocity | distance
0.10 | 0.03 | 0.00 | 0.00
0.10 | 0.01 | 0.00 | 0.00
0.10 | 0.00 | 0.00 | 0.00
0.10 | 0.01 | 0.00 | 0.00
0.10 | 0.02 | 0.00 | 0.00
0.10 | 0.02 | 0.00 | 0.00
0.10 | 0.01 | 0.00 | 0.00
0.10 | 0.02 | 0.00 | 0.00
0.10 | 0.02 | 0.00 | 0.00
0.10 | 0.01 | 0.00 | 0.00
0.10 | 0.02 | 0.00 | 0.00
0.10 | 0.02 | 0.00 | 0.00
0.10 | 0.00 | 0.00 | 0.00
0.10 | 0.03 | 0.00 | 0.00
0.10 | 0.03 | 0.00 | 0.00
0.10 | 0.01 | 0.00 | 0.00
0.10 | 0.04 | 0.00 | 0.00
0.10 | 0.04 | 0.00 | 0.00
0.10 | 0.01 | 0.00 | 0.00
0.10 | 0.04 | 0.00 | 0.00
0.10 | 0.03 | 0.00 | 0.00
0.10 | 0.01 | 0.00 | 0.00
0.10 | 0.02 | 0.00 | 0.00
0.10 | 0.02 | 0.00 | 0.00
0.10 | 0.16 | 0.02 | 0.00
0.10 | 0.16 | 0.02 | 0.00
0.10 | 0.03 | 0.00 | 0.00
0.10 | 0.35 | 0.04 | 0.01
0.10 | 0.56 | 0.06 | 0.01
0.10 | 0.60 | 0.06 | 0.01
0.10 | 1.04 | 0.10 | 0.02
0.10 | 0.82 | 0.08 | 0.02
0.10 | 1.60 | 0.16 | 0.03
0.10 | 1.60 | 0.16 | 0.04
0.10 | 1.15 | 0.12 | 0.04
0.10 | 1.38 | 0.14 | 0.05
0.10 | 1.38 | 0.14 | 0.06
0.10 | 1.55 | 0.16 | 0.06
0.10 | 1.54 | 0.15 | 0.07
0.10 | 1.90 | 0.19 | 0.08
0.10 | 0.72 | 0.07 | 0.08
0.10 | 0.36 | 0.04 | 0.09
0.10 | 1.88 | 0.19 | 0.10
0.10 | 2.31 | 0.23 | 0.11
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
