Escape9002/ArcherTracking/Arduino_Code/Tests/MPU_9250/Distance2/measuredDistances/constDistance3.csv

time | acc | velocity | distance
0.10 | 0.00 | 0.00 | 0.00
0.10 | 0.01 | 0.00 | 0.00
0.10 | 0.00 | 0.00 | 0.00
0.10 | 0.01 | 0.00 | 0.00
0.10 | 0.00 | 0.00 | 0.00
0.10 | 0.01 | 0.00 | 0.00
0.10 | 0.03 | 0.00 | 0.00
0.10 | 0.03 | 0.00 | 0.00
0.10 | 0.02 | 0.00 | 0.00
0.10 | 0.00 | 0.00 | 0.00
0.10 | 0.00 | 0.00 | 0.00
0.10 | 0.00 | 0.00 | 0.00
0.10 | 0.04 | 0.00 | 0.00
0.10 | 0.04 | 0.00 | 0.00
0.10 | 0.01 | 0.00 | 0.00
0.10 | 0.02 | 0.00 | 0.00
0.10 | 0.00 | 0.00 | 0.00
0.10 | 0.08 | 0.01 | 0.00
0.10 | 0.00 | 0.00 | 0.00
0.10 | 0.01 | 0.00 | 0.00
0.10 | 0.00 | 0.00 | 0.00
0.10 | 0.03 | 0.00 | 0.00
0.10 | 0.04 | 0.00 | 0.00
0.10 | 0.00 | 0.00 | 0.00
0.10 | 0.03 | 0.00 | 0.00
0.10 | 0.21 | 0.02 | 0.00
0.10 | 0.02 | 0.00 | 0.00
0.10 | 0.21 | 0.02 | 0.00
0.10 | 0.84 | 0.08 | 0.01
0.10 | 0.83 | 0.08 | 0.01
0.10 | 1.29 | 0.13 | 0.02
0.10 | 1.27 | 0.13 | 0.03
0.10 | 1.27 | 0.13 | 0.03
0.10 | 1.21 | 0.12 | 0.04
0.10 | 0.77 | 0.08 | 0.04
0.10 | 0.77 | 0.08 | 0.05
0.10 | 0.74 | 0.07 | 0.05
0.10 | 0.74 | 0.07 | 0.05
0.10 | 0.21 | 0.02 | 0.05
0.10 | 0.57 | 0.06 | 0.06
0.10 | 1.52 | 0.15 | 0.06
0.10 | 1.76 | 0.18 | 0.07
0.10 | 2.25 | 0.23 | 0.08
0.10 | 1.97 | 0.20 | 0.09
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
