Escape9002/ArcherTracking/Arduino_Code/Tests/MPU_9250/Distance2/measuredDistances/constDistance4.csv

time | acc | velocity | distance
0.10 | 0.01 | 0.00 | 0.00
0.10 | 0.00 | 0.00 | 0.00
0.10 | 0.00 | 0.00 | 0.00
0.10 | 0.03 | 0.00 | 0.00
0.10 | 0.02 | 0.00 | 0.00
0.10 | 0.02 | 0.00 | 0.00
0.10 | 0.01 | 0.00 | 0.00
0.10 | 0.02 | 0.00 | 0.00
0.10 | 0.02 | 0.00 | 0.00
0.10 | 0.01 | 0.00 | 0.00
0.10 | 0.02 | 0.00 | 0.00
0.10 | 0.01 | 0.00 | 0.00
0.10 | 0.03 | 0.00 | 0.00
0.10 | 0.03 | 0.00 | 0.00
0.10 | 0.00 | 0.00 | 0.00
0.10 | 0.03 | 0.00 | 0.00
0.10 | 0.01 | 0.00 | 0.00
0.10 | 0.02 | 0.00 | 0.00
0.10 | 0.04 | 0.00 | 0.00
0.10 | 0.00 | 0.00 | 0.00
0.10 | 0.00 | 0.00 | 0.00
0.10 | 0.03 | 0.00 | 0.00
0.10 | 0.02 | 0.00 | 0.00
0.10 | 0.00 | 0.00 | 0.00
0.10 | 0.00 | 0.00 | 0.00
0.10 | 0.02 | 0.00 | 0.00
0.10 | 0.01 | 0.00 | 0.00
0.10 | 0.03 | 0.00 | 0.00
0.10 | 0.03 | 0.00 | 0.00
0.10 | 0.03 | 0.00 | 0.00
0.10 | 0.04 | 0.00 | 0.00
0.10 | 0.02 | 0.00 | 0.00
0.10 | 0.03 | 0.00 | 0.00
0.10 | 0.10 | 0.01 | 0.00
0.10 | 0.05 | 0.01 | 0.00
0.10 | 0.19 | 0.02 | 0.00
0.10 | 0.30 | 0.03 | 0.01
0.10 | 0.30 | 0.03 | 0.01
0.10 | 0.25 | 0.02 | 0.01
0.10 | 0.42 | 0.04 | 0.01
0.10 | 0.03 | 0.00 | 0.01
0.10 | 0.38 | 0.04 | 0.01
0.10 | 1.58 | 0.16 | 0.02
0.10 | 1.74 | 0.17 | 0.03
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
