Escape9002/ArcherTracking/Arduino_Code/Tests/MPU_9250/Distance2/measuredDistances/PNG/constDistance6.png

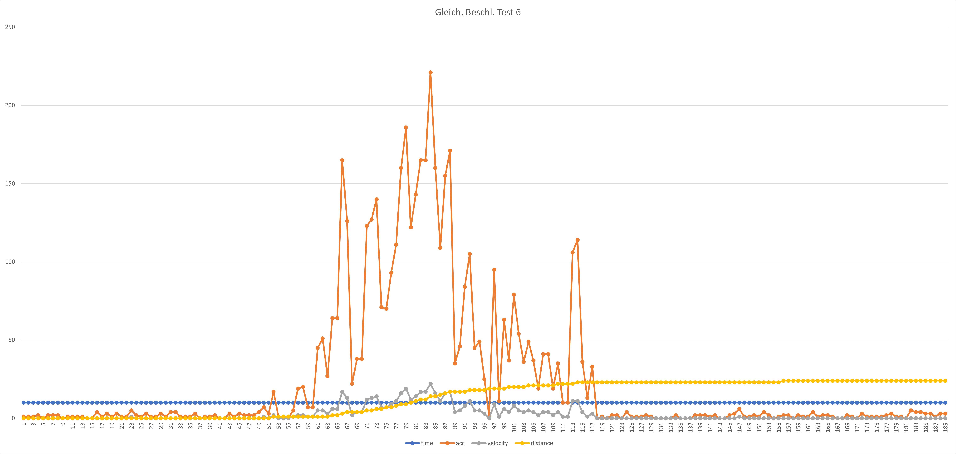
Arduino_Code/Tests/MPU_9250/Distance2/measuredDistances/PNG/constDistance6.png
