Escape9002/ArcherTracking/(threads)

Thread 10 (2021-10-07):

Check what Hz is running + if each Data String is single or doubled (connected with the Hz

Escape9002, 2021-10-07:
Wenn Arduino nur 1 mal sendet, handy aber 2 mal empfängt in selber zeit == ein datenstring doppelt pro aktualisierung des Arduinos

Escape9002, 2021-12-11:
neue MPU9250 bibliothek machst mögl! herz + wann sende ich werden manuell eingestellt + kontrolliert.

wenn keine neuen daten da sind, wird nicht gesendet

hz wird über sample rate divider eingestellt (siehe MPU9250 bibliothek)

Closed 2021-12-11.

Thread 5 (2021-10-07):

Stromverbrauch? Laufzeit mit verschiedenen Batterien/Akkus vs Gewicht

Escape9002, 2021-10-07:

Escape9002, 2021-10-07:
```
Ampere: 0,005 A
Volt: 7,4 V
Watt: 0,037 W
```
`Wattstunden : 133,2 Wh`
**Rechnung: Watt \* Sekunden \* Stunden**

`Amperestunden: 18Ah`
**Rechnung: Wattstunden / Volt**

Messung:

> Ampere: Zwischen Batterie + Arduino
> Volt: An gesamter Schaltung bei Last

Thread 8 (2021-10-07):

Neue Box?

Escape9002, 2021-10-07:
-Größe an Batterie anpassen
-Gummi streifen
-Deckel richtig machen
-LED-Status + Reset-Button erreichbar!

Escape9002, 2021-11-22:
See https://github.com/Escape9002/ArcherTracking/issues/5 for Details

2 CR2032 :

- Height: 2,5 mm
- Diameter: 20mm

Arduino Nano 33 BLE + MPU9250:

- Height  (on Platine): 20mm
- Length: 45mm
- width: 40 mm

> Arduino and IMU are next to eachother.

Size of box:

- keep care of shrink and too exact planning!

Escape9002, 2022-07-20:
Lipo-Ion-Akku + ESP32-C3 von Seeed, selber Sensor + Stoffband in den der Arduino gesteckt wird

Closed 2022-11-11.

Thread 13 (2021-11-27):

Distanz messen

Escape9002, 2021-11-27:
0,0000025 ist schon an sich am rand der nachkommastellen (7 von 7) bei float. da 2 mal anwendung nötig == kaputt. ansonsten fehler werte erwartbar und filter die jegliches signal schlucken ^^ FUCKKK
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

Escape9002, 2021-12-02:
https://www.youtube.com/watch?v=x33U7kiEkgQ&list=TLPQMDIxMjIwMjFG0AMt9kP6kg&index=1

got help here dont we?

Escape9002, 2021-12-08:
http://docs.ros.org/en/melodic/api/robot_localization/html/index.html

Escape9002, 2022-01-08:
Distanz wurde gemessen, bei Verwendung eines anderen Sensors lieferte die Integrale Formel korrekte Werte bei falsche Skalierung.

Formeln:
> Gleich. Beschl. :
```
t = (freq / 1000); //hz is not time but frequenzy
    distance = (distance) + /*(velocity * t) +*/ (acc * (t * t) * 0.5);
    velocity = acc * t;
```
> Integral:
```
 t = (freq / 1000); // hz to time
  velocity = t * ((acc + accOld) / 2) + velocity;
  accOld = acc;
  distance = t * ((velocity + velocityOld) / 2) + distance;
  velocityOld = velocity;
```

Getestet : 30cm fahren
> Gleich. Beschl. :  0.30 (+-0.05)
> Integral : 30 (+- 15)

Fehler der Rechnungen bei Stillstand sind typisch.

Closed 2022-01-08.

Thread 14 (2021-12-07):

6. Schriftliche Ausarbeitung

Escape9002, 2021-12-07:
□ Der Titel deiner Arbeit sollte nur eine Zeile lang sein. Am besten du benennst dein
Projekt kurz und knackig - bitte achte auf die korrekte Schreibweise!
□ Die Kurzfassung deiner Arbeit sollte 5-15 Zeilen beinhalten und ist im
Wettbewerbsprogramm hinterlegt. Erkläre in verständlicher Sprache, was du gemacht
hast, wie du vorgegangen bist und zu welchem Ergebnis du gekommen bist. Denke
daran, dass du nach dem Hochladen deiner Langfassung deine Kurzfassung erneut
überarbeitest, da diese aktualisierte Version später im Wettbewerbsheft abgedruckt
wird. Achte auch hier auf die korrekte Schreibweise!
□ Die Deadline zur Abgabe der Langfassung ist am 16.01.2022 bis 23:59 Uhr. Eine
verspätete Abgabe kann nicht berücksichtigt werden und führt zu einer Disqualifikation,
genauso wie eine Überschreitung der Länge: Die Langfassung darf maximal 15 Seiten
inclusive Anhang (ohne Literaturverzeichnis, Danksagung, Titel, Inhaltsverzeichnis,
etc.) und 30MB haben.
NEU: Bitte b

Escape9002, 2021-12-07:
rest in OneDrive sichtbar

Escape9002, 2022-01-15:
Arbeit unter Beachtung der Vorgaben eingereicht, Änderung bis 16.1.2022 23:59 Uhr möglich

Closed 2022-01-15.

Thread 18 (2021-12-07):

Befreiung vom Unterricht

Escape9002, 2021-12-07:

Escape9002, 2022-01-13:
Hinweis zu den aktuellen Planungen
Wir haben uns dazu entschieden, den Wettbewerb in Präsenz vor Ort in der Messe in Freiburg durchzuführen! Wir freuen uns, euch dies zu ermöglichen und werden alles dafür geben, einen sicheren Wettbewerb für euch zu organisieren.
Der Wettbewerb findet 1-tätig am Donnerstag, 17. Februar 2022 in der Messe in Freiburg statt. Wir machen uns jetzt sofort an die Detail-Planung und informieren euch nächste Woche im Teilnehmerbrief 2 über genaue Zeiten und Planungen.
Was jetzt schon feststeht: Der Wettbewerb wird unter 2G+ Bedingungen stattfinden. Schüler/innen und Schüler bis 17 Jahre sind laut Info der Landesregierung auch im Februar weiterhin von der 2G Regel ausgenommen, es reicht ein Schülerausweis. Für das „Plus“ werden wir Testmöglichkeiten organisieren und ALLE Teilnehmer/innen und sämtliche Mitwirkende vor Ort mit einem Schnelltest testen.

out of the Email send to me

Escape9002, 2022-01-15:
Pending

hibbes, 2022-01-15:
Acknowledged

Thread 22 (2021-12-07):

Matlab benutzen

Escape9002, 2021-12-07:
visualisierung der daten und kalibrierung + genauigkeit ^^

Escape9002, 2021-12-07:
https://de.mathworks.com/help/nav/ref/imusensor-system-object.html

https://de.mathworks.com/help/nav/ref/accelparams.html

https://de.mathworks.com/help/nav/ref/imu.html

https://medium.com/@mikehorton/how-to-run-an-accurate-inertial-navigation-simulation-in-less-than-5-minutes-df427f69d464

https://www.youtube.com/watch?v=6ijArKE8vKU

Escape9002, 2021-12-07:
YT- video:
The work presented was conducted by Sebastian O.H. Madgwick during his Ph.D research at the University of Bristol.

For more information and source code, see:
http://www.x-io.co.uk/gait-tracking-w...

Escape9002, 2021-12-08:
https://developers.aceinna.com/docs/simulationhelp

MAtlab lizenzproblem try this instead

Escape9002, 2021-12-11:
matlab bekommen, shop ist down, tutorial wird erstmal ohne lib verfolgt.

Escape9002, 2021-12-12:
SensorFusion erweiterung bekommen, problem:

MPU9250 wird nicht  erkennt (adresse (0x68 wird erkannt, ausgabe : wrong sesor connected, reconfigure hardware and try again)

mpu6050 funktioniert --> kein Magnetometer || Temperatur sensor =/

3D Visualisierung sollte dennoch mögl sein, [Hier](https://de.mathworks.com/help/supportpkg/arduinoio/ug/estimating-orientation-using-inertial-sensor-fusion-and-mpu9250.html)

1. MPU9250 as MPU6050 --> same sample rate etc? Richtige befehle in der Bibliothek?
2. 3D Visualisierung ohne Mag-Sensor mögl?

Escape9002, 2021-12-13:
Neuen/anderen MPU9250 benutzt, guess what, it works!!!!

Super cool ^^

Escape9002, 2021-12-30:
https://www.cbcity.de/tutorial-rotationsmatrix-und-quaternion-einfach-erklaert-in-din70000-zyx-konvention

Ausprobieren !

Escape9002, 2022-01-08:
Orientierung kann berechnet und angezeigt werden! Einzusehen unter Matlab/Orientierung/OrientierungsPlot.m

Filter einsetzen
> Roll + Pitch mit accl + gyro (+ mag)
> yaw mit gyro + mag

Distanz zu dem Plot hinzufügen
> Kalibrierung des Sensors mithilfe aller anderer Sensoren
> Wie plotten?
> Korrekte Formel benutzen [Siehe Kommentar](https://wolles-elektronikkiste.de/mpu9250-9-achsen-sensormodul-teil-2)

Escape9002, 2022-03-10:
Matlab fusioniert Daten und liefert Datensatz für OpenSim.
Verwendung abgeschlossen

Closed 2022-03-10.

Thread 24 (2022-01-15):

Präsentation planen

Escape9002, 2022-01-15:
Präsenz-Präsentation:

- [x]  Präsi mit Bildern statt Text

- [x]  Euler Winkel + Quaternionen
- [x]  Live-Vorführung
- [x]  genauere Bewegungsanalyse: was brauche ich wirklich?
- [ ]  Bilder des Codes (Handy, Arduino, Matlab) bzw dabei haben!

Escape9002, 2022-01-18:
Darstellung in Latex:
https://tex.stackexchange.com/questions/118131/how-to-plot-a-surface-from-a-set-of-data

Latex + Plakat:
https://www.benjamin-rosemann.de/post/2014/tricks-fuer-praesentationen-mit-latex-beamer-und-tikz/

Escape9002, 2022-01-22:
https://www.youtube.com/watch?v=ernjVNQrj68

Closed 2022-02-26.

Thread 25 (2022-01-15):

Visuelle Darstellung am Handy

Escape9002, 2022-01-15:
- [x]  Clean-up des Codes
- [x]  Empfangen 1er oder mehrerer Characteristics || Sensoren
- [x] 3D-Darstellung via Matlab + Python

Escape9002, 2022-01-16:
Benutzung der Distanz nicht möglich, Werte sind zu empfindlich
> Abstützen auf Schreibtisch: Wert gegen +
> Hände weg: Wert gegen -

Orientierung berechnen und verwenden!

Escape9002, 2022-01-18:
3D-Darstellung am Handy via AppInventor kaum/nicht möglich --> Matlab (+python) verwenden!

- [ ] 3D-Darstellung via Matlab + Python

Verwende dazu doch:
https://de.mathworks.com/campaigns/offers/matlab-python-cheat-sheets.html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

Escape9002, 2022-01-20:
https://docs.opencv.org/4.x/dc/d2c/tutorial_real_time_pose.html

Open CV für kontrolle der Daten

Escape9002, 2022-01-22:
gesuchte Darstellung: Kinematic plot

Closed 2022-02-26.

Thread 26 (2022-01-15):

MachineLearning realisieren (einfaches)

Escape9002, 2022-01-15:
- [x]  Android-Funktion zur Aufnahme der Daten im richtigen Format
- [x]  Trainieren des Modells
- [ ]  Laufen in IDE oder Handy?

Escape9002, 2022-01-20:
Aufnahme der daten (Gyroskop und Accel) findet jetzt statt (getrennte dateien),
!Keine unterscheidung von Schüssen!

Escape9002, 2022-02-26:
Neuronales Netz anfänglich realisiert. Starke Verbeserung nötig!

Closed 2022-02-26.

Thread 27 (2022-01-15):

Box aktualisieren

Escape9002, 2022-01-15:
- [x]  Re-Design Box for CR2025 oder die Akkus die ich hab.
- [x]  Print
- [ ]  Ausstatten mit entsprechenden Gummis

Escape9002, 2022-01-16:
70*50*20 mm für Platine
47*41*20 für Arduino + MPU9250
leerraum unter MPU: 16*21*20

Escape9002, 2022-01-16:
aktuelle Box: 80 * 60 * 27

Escape9002, 2022-01-31:
Box wurde von [SyntaxError](https://github.com/AHHD456) designed

Closed 2022-02-26.

Thread 28 (2022-03-10):

OpenSim - besserer Datensatz

Escape9002, 2022-03-10:
Bogenschießbewegung aufnehmen!

Escape9002, 2022-03-18:
neue Datensätze, sind falsch orientiert mit den aktuell verwendeten Torso || Pelvis -Daten.
Korrektur: 9V-Volt in Packung + zu Schreibtisch gucken + 9-volt müssen nach oben gucken + Deckel weg von Körper

Escape9002, 2022-03-19:
Daten sind am 3D-Modell falsch orientiert! vor dem IMU-Placer muss der Grundstand des Datensatzes vom 3D-Modell eingenommen werden.
