Escape9002/ArcherTracking/Documentation/2021/Wettbewerb/Plakat/Archer-Tracker.pdf

# Schützenvermessung als DIY-Version

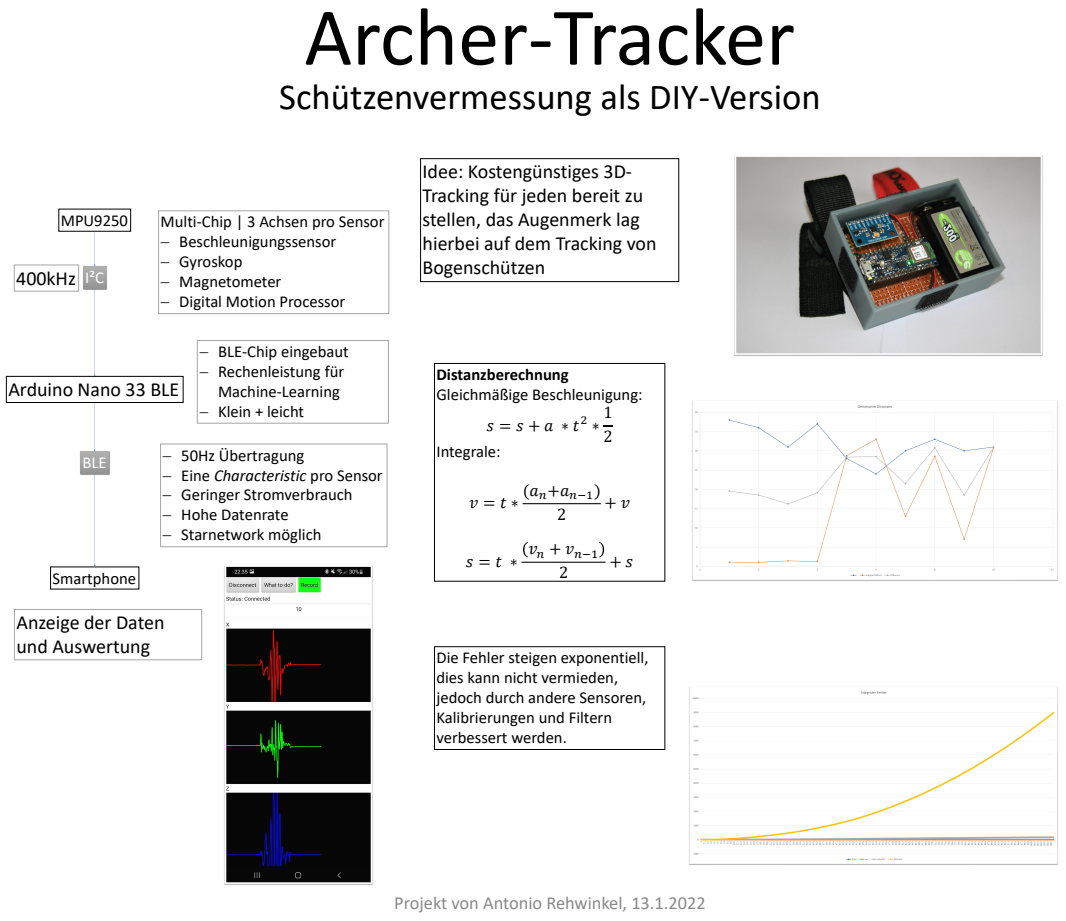
[picture p68: page 1]
I²C; MPU9250; BLE; Smartphone; 400kHz; Distanzberechnung Gleichmäßige Beschleunigung:; Integrale:

Idee: Kostengünstiges 3D-
Tracking für jeden bereit zu
stellen, das Augenmerk lag
hierbei auf dem Tracking von
Bogenschützen

Multi-Chip | 3 Achsen pro Sensor
− Beschleunigungssensor
− Gyroskop
− Magnetometer
− Digital Motion Processor

− BLE-Chip eingebaut
− Rechenleistung für
Machine-Learning
− Klein + leicht

Arduino Nano 33 BLE

− 50Hz Übertragung
− Eine Characteristic pro Sensor
− Geringer Stromverbrauch
− Hohe Datenrate
− Starnetwork möglich

Anzeige der Daten
und Auswertung

Die Fehler steigen exponentiell,
dies kann nicht vermieden,
jedoch durch andere Sensoren,
Kalibrierungen und Filtern
verbessert werden.

Projekt von Antonio Rehwinkel, 13.1.2022
