Escape9002/ArcherTracking/MATLAB/TestsNTutorials/Tests/Results/graph_flex.pdf

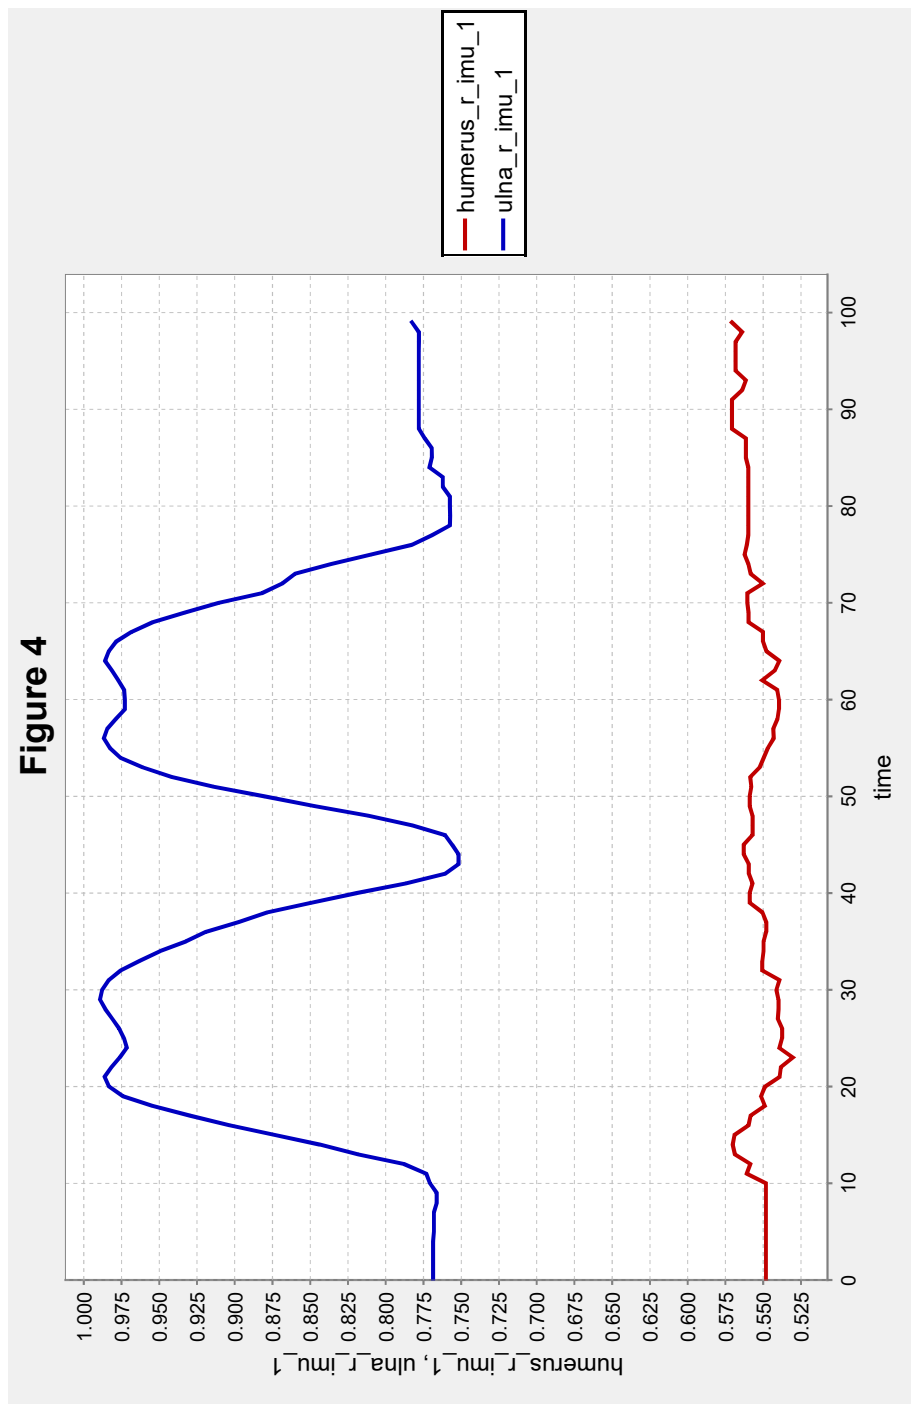
[picture p69: page 1]
Figure 4 humerus_r_imu_1 ulna_r_imu_1; 0 10 20 30 40 50 60 70 80 90 100 time 1.000 0.975 0.950 0.925 0.900 0.875 0.850 0.825 0.800 0.775 0.750 0.725 0.700 0.675 0.650 0.625 0.600 0.575 0.550 0.525
