Escape9002/ArcherTracking/MATLAB/TestsNTutorials/Tests/Results/graphg_dance.pdf

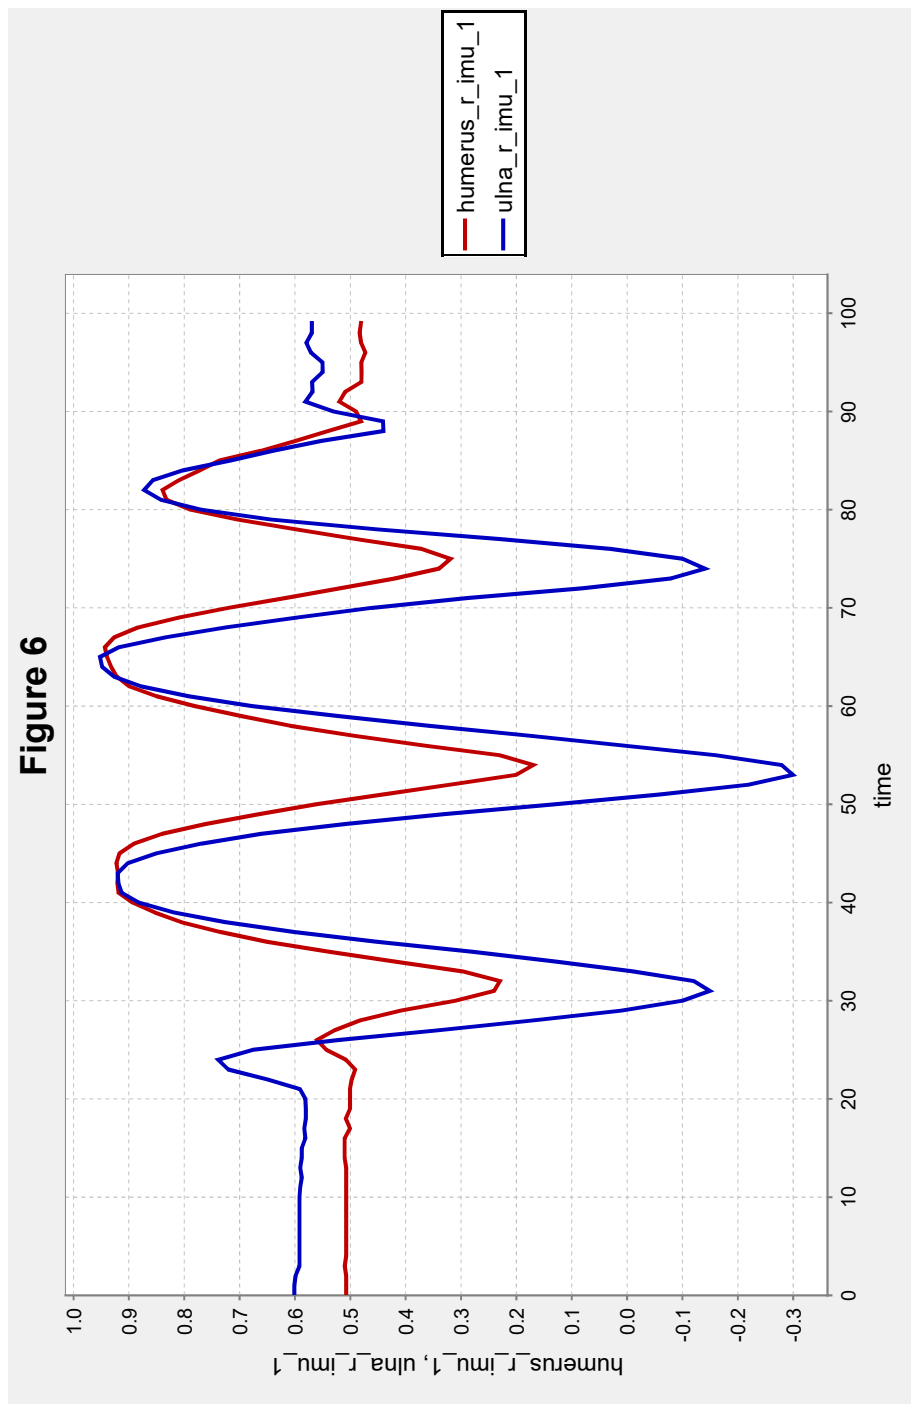
[picture p70: page 1]
Figure 6 humerus_r_imu_1 ulna_r_imu_1; 0 10 20 30 40 50 60 70 80 90 100 time -0.1 -0.2 -0.3 1.0 0.9 0.8 0.7 0.6 0.5 0.4 0.3 0.2 0.1 0.0
