Escape9002/ArcherTracking/Arduino_Code/Firmware/ArduinoNano33Ble/Arduino33BLEVol1/Arduino33BLEVol1.ino

int i = 0;



#include <ArduinoBLE.h>

// Device name
const char* nameOfPeripheral = "BLEEE";
const char* uuidOfService = "0000181a-0000-1000-8000-00805f9b34fb";
const char* uuidOfRxChar = "00002A3D-0000-1000-8000-00805f9b34fb";
const char* uuidOfTxChar = "00002A58-0000-1000-8000-00805f9b34fb";

// BLE Service
BLEService TestService(uuidOfService);

// Setup the incoming data characteristic (RX).
const int RX_BUFFER_SIZE = 256;
bool RX_BUFFER_FIXED_LENGTH = false;

// RX / TX Characteristics
BLECharacteristic rxChar(uuidOfRxChar, BLEWriteWithoutResponse | BLEWrite, RX_BUFFER_SIZE, RX_BUFFER_FIXED_LENGTH);
BLEByteCharacteristic txChar(uuidOfTxChar, BLERead | BLENotify | BLEBroadcast);

// Buffer to read samples into, each sample is 16-bits
short sampleBuffer[256];

// Number of samples read
volatile int samplesRead;


  void setup() {

  // Start serial.
  Serial.begin(9600);

  // Ensure serial port is ready.
  //while (!Serial);

  // Prepare LED pins.
  pinMode(LED_BUILTIN, OUTPUT);
  pinMode(LEDR, OUTPUT);
  pinMode(LEDG, OUTPUT);

  // Start BLE.
  startBLE();

  // Create BLE service and characteristics.
  BLE.setLocalName(nameOfPeripheral);
  BLE.setAdvertisedService(TestService);
  TestService.addCharacteristic(rxChar);
  TestService.addCharacteristic(txChar);
  BLE.addService(TestService);

  // Bluetooth LE connection handlers.
  BLE.setEventHandler(BLEConnected, onBLEConnected);
  BLE.setEventHandler(BLEDisconnected, onBLEDisconnected);

  // Event driven reads.
  rxChar.setEventHandler(BLEWritten, onRxCharValueUpdate);

  // Let's tell devices about us.
  BLE.advertise();

    // Print out full UUID and MAC address.
  Serial.println("Peripheral advertising info: ");
  Serial.print("Name: ");
  Serial.println(nameOfPeripheral);
  Serial.print("MAC: ");
  Serial.println(BLE.address());
  Serial.print("Service UUID: ");
  Serial.println(TestService.uuid());
  Serial.print("rxCharacteristic UUID: ");
  Serial.println(uuidOfRxChar);
  Serial.print("txCharacteristics UUID: ");
  Serial.println(uuidOfTxChar);
  

  Serial.println("Bluetooth device active, waiting for connections...");


}

void loop()
{
  BLEDevice central = BLE.central();
  
  if (central)
  {
    // Only send data if we are connected to a central device.
    while (central.connected()) {
      connectedLight();
      // Send the microphone values to the central device.
      if (samplesRead) {
        // print samples to the serial monitor or plotter
        for (int i = 0; i < samplesRead; i++) {
          txChar.writeValue(sampleBuffer[i]);      
        }
        // Clear the read count
        samplesRead = 0;
      }
    }
    disconnectedLight();
  } else {
    disconnectedLight();
  }
}

/*
 *  BLUETOOTH
 */
void startBLE() {
  if (!BLE.begin())
  {
    Serial.println("starting BLE failed!");
    while (1);
  }
}
void onRxCharValueUpdate(BLEDevice central, BLECharacteristic characteristic) {
  // central wrote new value to characteristic, update LED
  Serial.print("Characteristic event, read: ");
  byte tmp[256];
  int dataLength = rxChar.readValue(tmp, 256);

  for(int i = 0; i < dataLength; i++) {
    Serial.print((char)tmp[i]);
  }
  Serial.println();
  Serial.print("Value length = ");
  Serial.println(rxChar.valueLength());
}

void onBLEConnected(BLEDevice central) {
  Serial.print("Connected event, central: ");
  Serial.println(central.address());
  connectedLight();
}

void onBLEDisconnected(BLEDevice central) {
  Serial.print("Disconnected event, central: ");
  Serial.println(central.address());
  disconnectedLight();
}

/*
 * LEDS
 */
void connectedLight() {
  digitalWrite(LEDR, LOW);
  digitalWrite(LEDG, HIGH);
}


void disconnectedLight() {
  digitalWrite(LEDR, HIGH);
  digitalWrite(LEDG, LOW);
}


/* doess Github work? i dont know*/
