Escape9002/ArcherTracking/MATLAB/OpenSim/sensorData_Conector.py

import csv

def load_data(header, fileName):
    dataArray1 = []
    outputArray = []
    with open(fileName, newline='') as csvfile:
        file = csv.reader(csvfile, delimiter=' ')

        i=0
        while i < header:
            i = i+ 1
            next(file)
        
        for row in file:
            for data in row:
                dataArray1.append(data.split("\t"))

        for data in dataArray1:
            outputArray.append(data[1] + "\t" + data[2])
    print(outputArray)
    return outputArray

def write_data(filename,kopfzeile,data1, data2):
    with open(filename, 'w') as data:
        data.write(kopfzeile)
        i = 0
        while i < len(data1):
            msg = str(i) + "\t" + str(data1[i]) + "\t" + str(data2[i]) + "\n"
            i = i+1
            data.write(msg)

huefte = load_data(6, 'data_huefte.sto')    # sensor data file 1
flex = load_data(6,'data_flex.sto') # sensor data file 2
lift = load_data(6,'data_lift.sto') # optional
dance = load_data(6,'data_dance.sto')   # optional

# this appends the collumns of both files, keep in mind to redefine your header!
write_data('appendData_flex.sto',
    "DataRate=50.000000\nDataType=Quaternion\nversion=3\nOpenSimVersion=4.3-2021-08-27-4bc7ad9\nendheader\ntime\ttorso_imu\tpelvis_imu\thumerus_r_imu\tulna_r_imu\n",huefte,flex)

# optional
write_data('appendData_lift.sto',
    "DataRate=50.000000\nDataType=Quaternion\nversion=3\nOpenSimVersion=4.3-2021-08-27-4bc7ad9\nendheader\ntime\ttorso_imu\tpelvis_imu\thumerus_r_imu\tulna_r_imu\n",huefte,lift)
# optional
write_data('appendData_dance.sto',
    "DataRate=50.000000\nDataType=Quaternion\nversion=3\nOpenSimVersion=4.3-2021-08-27-4bc7ad9\nendheader\ntime\ttorso_imu\tpelvis_imu\thumerus_r_imu\tulna_r_imu\n",huefte,dance)
