Escape9002/ArcherTracking/(commit log)

2021-06-13 Last few Ordners
    [punch.csv]
2021-10-13 New Splitter + data types
    [1061_Shooting.csv, 1668_Shooting.csv, 1768_Shooting.csv, 2305_Shooting.csv, 2451_Shooting.csv, 2601_Shooting.csv, 2865_Shooting.csv, 3399_Shooting.csv]
2021-10-21 newBoxes wrong scale
    [ArcherBox v7.stl, ArcherDeckel v4.stl]
2021-10-26 somehow, somewhen it is not working
    this is now
    [1061_Shooting.csv, 2865_Shooting.csv]
2021-11-11 Lucca pls help
    [months - Kopie.csv]
2021-11-12 new shit aquired
    [months.csv]
2021-11-13 something worked...
    [Shot.csv, months - Kopie.csv]
2021-11-13 Yes.....splitting or something
    [1668_Shooting.csv, 1768_Shooting.csv, 2305_Shooting.csv, 2451_Shooting.csv, 2601_Shooting.csv, 2865_Shooting.csv, 3399_Shooting.csv, 4455_Shooting.csv]
2021-11-18 i dont even remember
    [830_Shooting.csv, DataSplit_0_1061_Shooting.csv, DataSplit_10_5649_Shooting.csv, DataSplit_11_6396_Shooting.csv, DataSplit_12_6596_Shooting.csv, DataSplit_13_6623_Shooting.csv, DataSplit_14_7353_Shooting.csv, DataSplit_15_830_Shooting.csv]
2021-11-22 added Sources
    [DataSplit_0_1061_Shooting.csv, DataSplit_10_5649_Shooting.csv, DataSplit_11_6396_Shooting.csv, DataSplit_12_6596_Shooting.csv, DataSplit_13_6623_Shooting.csv, DataSplit_14_7353_Shooting.csv, DataSplit_15_830_Shooting.csv, DataSplit_1_1668_Shooting.csv]
2021-12-04 New Data, New Code, New Ml-Model
    meh =/
    [4161_Shooting.csv, DataSplit_0_4161_Shooting.csv, click.csv, flex.csv, left.csv, months.csv, punch.csv, right.csv]
2021-12-05 HelloThere, didnt manage Undertale =/
    [left.csv, punch.csv, rigth.csv]
2021-12-09 new test and sources
    Motion Link and Smart motion require "Neo " board, not an option. also only visualize data in graphs?
    source is about ML and archers capabilities
    new arduino code + lib
2021-12-11 guess what we did
    konnte es nicht ausprobieren, shop für Sensor fusion etc ist down =/
2021-12-11 new data + made code runtime finish
    [left.csv, punch.csv, rechts.csv]
2021-12-11 different corrections
    Android fileNames, new MLData, new ArduinoVol8
    [left.csv, punch.csv, right.csv]
2021-12-16 corrected axxel, pos tracking nearly working
    [Test_Vol1.ino]
2021-12-16 Currently reconfigering all
2021-12-16 Get IMU_Data
2021-12-16 get a set of IMU_Data
2021-12-16 plot the IMU_Data set in a graph
2021-12-16 Connection help with MPU9250, problem was solved with new sensor
    [Distance.ino]
2021-12-16 currently loading.
    [left.csv, punch.csv]
2021-12-16 swing left/ right data set
    MPU9250 + LMS9D1 !!!Keine Anapssung der Daten!!! falsches daten set!
    [left.csv, punch.csv]
2021-12-16 Suddenly the output changed, apperently the velocity was my distance ?!
2021-12-17 Distance not measurable, wrong formula?
    [Distance.ino]
2021-12-17 found possible problem
    acceleration in one dirrection works, with !deacclerating! the value resets to zero. this is due to both velocitys being equal (no loss of energy). but how to solve?
    [Distance.ino]
2021-12-17 added Offset calculator based on average values(200 samples) no true result
    too high hz= noise, too low = unresponsive,
    distance is noisy (as expected by double integration?)
    [Distance2.ino]
2021-12-28 DataSet from DIstance2 code
    Raw Data and Pictures
    [constDistance.csv, constDistance2.csv, constDistance3.csv, constDistance4.csv, integralDistance.csv, integralDistance2.csv, integralDistance3.csv, integralDistance4.csv]
2021-12-31 Formel Erklärung + Tests
    Tests Ergebnisse und kurze durchführung
2022-01-03 get the degree from accl or gyroscope
2022-01-04 failed TestCode
    Tried logging data automatically with a EV3. Failed due to pure noise
    [Distance2.ino]
2022-01-05 Euler Plot works better than SensorFusion, correct values chosen?
2022-01-06 new Analysis Picutres and Texts
    [constDistance001.csv, constDistance10.csv, constDistance5.csv, constDistance6.csv, constDistance7.csv, constDistance8.csv, constDistance9.csv, integralDistance001.csv]
2022-01-06 reset Code to work with Serial Monitor
    [Distance2.ino]
2022-01-07 sensorFusion
    gyro is to sensitive, false formular
2022-01-08 Working Orientation Code!
    may add complementary filter?
2022-01-08 changed commata
    take a look at matlab-orientation Plot for correct degrees of yaw!
    [Degree2.ino]
2022-01-08 new Data
    [pitch.csv, roll.csv, yaw.csv]
2022-01-08 Probe lesen
2022-01-13 edited Powerpoint
2022-01-23 implementing openCV, first recognition working
    no calibration needed, still got some pics of a chess board, videos not provided!
2022-01-30 got an error, i dont understand
    [680_Shooting.csv, Shooting_5.csv]
2022-01-31 new Box, designed by SyntaxError
    https://github.com/AHHD456
    [ArcherBox v8.stl]
2022-01-31 top designed by SyntaxError
    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
    [ArcherDecker v5.stl]
2022-02-02 running simulation
    [Shooting_5.csv]
2022-02-03 added correct SampleTimeFine
2022-02-05 new FolderStructure, cleanup of code
    [time.csv]
2022-02-05 folder structure and guide
    [time.csv]
2022-02-05 enabled the Magnetometer
    With this, the MachineLearning Data can not consist of all the data I have, but explicitly only with the accel and gyro. Reason: to high specificity of data
2022-02-07 working simulation
    with misplaced IMU on Ulna-bone, that's why it is laggy
2022-02-08 Corrected values and info on MPU9250 library
    [Arduino33BLEVol8.ino]
2022-02-20 new Folder arrangement
    [1061_Shooting.csv, 1668_Shooting.csv, 1768_Shooting.csv, 2305_Shooting.csv, 2451_Shooting.csv, 2601_Shooting.csv, 2865_Shooting.csv, 3399_Shooting.csv]
2022-03-02 added Quaternions and Euler-Angles
    new inversive Kinematic section
2022-03-03 added small subsection "Inversive Kinematics"
2022-03-19 took new torso/pelvis data + tested
    if arm sensors aren't placed facing the same as pelvis, results are false....
2022-03-20 new Data
    walking and digging data to compare with Shooting-Data
    [4455_Shooting.csv, punch.csv]
2022-03-25 data Connector
    [flex.csv, punch.csv]
2022-03-25 try MachineLearning
    not working
    [IMU_Capture.ino, IMU_Classifier.ino]
2022-05-19 New Firmware
    Computation of Quaternions on the DMP of the MPU9250!
    - Correct Orientation ?
    - Sending times?
    [Arduino33BLEVol9.ino]
2022-05-23 Seminararbeit
    1.5 Zeilenabstand
    Verlauf der Arbeit
    Selsbtändigkeitserklärung
2022-05-30 some format stuff
    final printed version
2022-06-12 writeData from Ser.Bus
    and include header for OpenSim
    currently single sensor only
2022-06-15 finished databus Arduino - python
    switch to quaternion halfed to needed bandwith but needs a bit more CPU power. Nothing to worry bout though?
    old Format[20]:
    [pxx.xx,pxx.xx,pxx.xx]
    new format[11]:
    xxx,xxx,xxx
    needs some transformation: quat *100 + 100 = x and x can be 0 to 200
2022-06-15 switched to new databus
2022-06-19 multi Sensor Read
    and new data
2022-11-11 cleanup and added Readme's for better orientation
    [ArcherBox v7.stl, ArcherDeckel v4.stl]
